OneFinityCNC/onefinity-pcb/BOM/ControllerRev5.xlsx

Controller Revision 5
Bill Of Materials
Item | Quantity | Reference | Part | Manufacturer | Manufacturer Part Number | Description
1 | 10 | C1,C2,C3,C35,C36,C37,C65,C81,C97,C113 | 130p/50V | Kemet | C0805C131J5GAC7800 | CAP CER 130PF 50V NP0 0805
2 | 23 | C4,C5,C6,C7,C8,C9,C18,C19,C24,C25,C28,C32,C33,C34,C62,C78,C94,C110,C115,C119,C120,C121,C123 | 100n/50V | Kemet | C0805C104M5RACTU | CAP CER 0.1UF 50V X7R 0805
3 | 2 | C10,C11 | 10p/50V | Kemet | C0805C100J5GACTU | CAP CER 10PF 50V C0G/NP0 0805
4 | 1 | C12 | 3n3/50V | Kemet | C0805C332K5RACTU | CAP CER 3300PF 50V X7R 0805
5 | 1 | C13 | 22u/16V | Murata | GRM32ER71E226ME15L | CAP CER 22UF 25V X7R 1210
6 | 2 | C14,C124 | 10u/50V | Taiyo Yuden | UMK325BJ106KM-T | CAP CER 10UF 50V X5R 1210
7 | 1 | C15 | 470n/50V | Kemet | C0805C474K5RACTU | CAP CER 0.47UF 50V X7R 0805
8 | 1 | C16 | 100p/16V | Wurth Elektronik | 885012007016 | CAP CER 100PF 16V C0G/NP0 0805
9 | 1 | C17 | 33n/50V | Kemet | C0805C333K5RACTU | CAP CER 0.033UF 50V X7R 0805
10 | 15 | C27,C29,C30,C31,C38,C39,C40,C42,C44,C45,C46,C47,C48,C49,C50 | 220n/16V | Yageo | CC0805KRX7R7BB224 | CAP CER 0.22UF 16V X7R 0805
11 | 13 | U7,C41,C43,C51,C67,R68,R69,R71,R73,C83,C99,R134,R135 | DNI
12 | 8 | C52,C53,C68,C69,C84,C85,C100,C101 | 22u/50V | Wurth | 865080643008 | CAP ALUM 22UF 20% 50V SMD
13 | 8 | C54,C58,C70,C74,C86,C90,C102,C106 | 10n/50V | Yageo | CC0805KRX7R9BB103 | CAP CER 10000PF 50V X7R 0805
14 | 5 | C55,C71,C87,C103,C130 | 150u/50V | Wurth | 865080657017 | CAP ALUM 150UF 20% 50V SMD
15 | 8 | C56,C57,C72,C73,C88,C89,C104,C105 | 22u/63V | Wurth Electronik | 860010773010 | CAP 22 UF 20% 63 V
16 | 4 | C59,C75,C91,C107 | 220n/100V | Taiyo Yuden | HMK212B7224KG-T | CAP CER 0.22UF 100V X7R 0805
17 | 9 | C60,C63,C76,C79,C92,C95,C108,C111,C122 | 1u/50V | Samsung Electro-Mechanics | CL21B105KBFNNNE | CAP CER 1UF 50V X7R 0805
18 | 12 | C61,C64,C66,C77,C80,C82,C93,C96,C98,C109,C112,C114 | 1n/16V | Kemet | C0805C102K4RACTU | CAP CER 1000PF 16V X7R 0805
19 | 1 | C116 | 180u/50V | United Chemi-Con | EKZN500ELL181MH20D | CAP ALUM 180UF 20% 50V RADIAL
20 | 4 | D1,D4,D5,D6 | 3A/40V | STMicroelectronics | STPS3L40UF | DIODE SCHOTTKY 40V 3A SMBFLAT
21 | 2 | D7,D8 | 33V/3kW | Littelfuse | SMDJ33A | ESD Suppressors / TVS Diodes 3kW 33V 5% Uni-Directional
22 | 1 | D9 | LED Green | Lite-On | LTST-S270KGKT | LED GREEN CLEAR CHIP SMD R/A
23 | 1 | D10 | BAV99 | ON Semi | BAV99LT1G | DIODE ARRAY 100V 215MA SOT23-3
24 | 1 | D12 | BAS16 | Nexperia | BAS16,215 | DIODE GP 100V 215MA TO236AB
25 | 1 | J1 | CONN RCPT 20x2 | Amphenol FCI | 68602-440HLF | CONN HEADER VERT 40POS 2.54MM
26 | 1 | J2 | I2C Debug
27 | 1 | J3 | Serial Debug
28 | 2 | J4,J9 | CON6A | FCI | 67996-206HLF | CONN HEADER 6POS .100 STR 15AU
29 | 1 | J5 | Power In | Molex | 39300060
30 | 2 | J7,J8 | LOAD | Amphenol FCI | 10127720-061LF | CONN HEADER R/A 6POS 3MM
31 | 2 | J10,J11 | CON2 | Amphenol FCI | 10127720-021LF | Power to the Board Hdr,Dbl Rw, R/A, T/H 2P, Tin Plating
32 | 4 | J12,J13,J14,J15 | MOTOR | Amphenol ICC (FCI) | 10127720-041LF | CONN HEADER R/A 4POS 3MM
33 | 1 | J16 | Fan | Molex | MOLEX-22-23-2021 | CONN HEADER VERT 2POS 2.54MM
34 | 1 | J17 | Power Button | Molex | 22-23-2041 | CONN HEADER VERT 4POS 2.54MM
35 | 1 | J18 | Rocker Switch | Molex | MOLEX-22-23-2021 | CONN HEADER VERT 2POS 2.54MM
36 | 1 | L1 | 10u | Bourns Inc. | SRN8040-100M | FIXED IND 10UH 3.1A 50 MOHM SMD
37 | 1 | L2 | SRF2012A-121YA | Bourns | SRF2012A-121YA | CMC 400MA 2LN 120OHM SMD AECQ200
38 | 1 | L3 | 470R/700mA | Murata | BLM21AG471SN1D | - Ferrite Bead 0805 (2012 Metric) 700mA 190mOhm
39 | 1 | M1 | RasPi 3B+ | Raspberry Pi | RASPBERRY PI 3 MODEL B+ | RASPBERRY PI 3 MOD B+ BCM2837B0
40 | 4 | M2,M3,M4,M5 | 25MM Standoff M3 | Keystone Electronics | 25515 | HEX STANDOFF M3 NYLON 25MM
41 | 8 | M6,M7,M8,M9,M10,M11,M12,M13 | M3 Screw 5mm | B&F Fastener Supply | MPMS 003 0005 PH | MACH SCREW PAN HEAD PHILLIPS M3
42 | 2 | M14,M17 | IDC Socket 40P | Assmann WSW Components | AWP 40-7540-T | CONN SOCKET 40POS IDC TIN
43 | 2 | M15,M18 | Strain Relief | Assmann WSW Components | AWZ-40-T | CONN STRAIN RELIEF 40POS
44 | 1 | M16 | Ribbon Cable | 3M | 3365/40 300 | CBL RIBN 40COND 0.050 GRAY 100'
45 | 1 | P1 | CONNECTOR DB25 | NorComp | 182-025-113R161 | CONN D-SUB PLUG 25POS R/A SOLDER
46 | 1 | Q1 | 60V/50A | Vishay Siliconix | SUD50P06-15L-E3 | MOSFET P-CH 60V 50A TO252
47 | 6 | Q7,Q11,Q12,Q14,Q15,Q16 | 2N7002 | Vishay Siliconix | 2N7002K-T1-E3 | MOSFET N-CH 60V 300MA SOT-23
48 | 1 | Q10 | MMBT2907 | Diodes Inc | MMBT2907A-7-F | TRANS PNP 60V 0.6A SOT23-3
49 | 1 | Q13 | DMG2305 | Diodes Incorporated | DMG2305UX-13 | MOSFET P-CH 20V 4.2A SOT23
50 | 7 | R1,R5,R64,R88,R99,R110,R121 | 2k4 | Yageo | RC0805FR-072K4L | RES SMD 2.4K OHM 1% 1/8W 0805
51 | 25 | R2,R3,R4,R6,R7,R55,R56,R61,R79,R81,R84,R89,R90,R92,R95,R100,R101,R103,R106,R111,R112,R114,R117,R122,R127 | 180R | Stackpole Electronics Inc | RMCF0805JT180R | RES 180 OHM 5% 1/8W 0805
52 | 1 | R8 | 10k5 | Yageo | RC0805FR-0710K5L | RES 10.5K OHM 1% 1/8W 0805
53 | 1 | R9 | 180k | Yageo | RC0805FR-07180KL | RES SMD 180K OHM 1% 1/8W 0805
54 | 11 | R10,R43,R506,R509,R511,R512,R520,R524,R530,R532,R536 | 10k | Yageo | RC0805FR-0710KL | RES SMD 10K OHM 1% 1/8W 0805
55 | 1 | R11 | 330R | Yageo | RC0805FR-07330RL | RES SMD 330 OHM 1% 1/8W 0805
56 | 2 | R12,R13 | 1k37 | Yageo | RC0805FR-071K37L | RES SMD 1.37K OHM 1% 1/8W 0805
57 | 1 | R14 | 1k5 | Yageo | RC0805FR-071K5L | RES SMD 1.5K OHM 1% 1/8W 0805
58 | 7 | R32,R33,R129,R130,R507,R508,R531 | 37k4 | Yageo | RC0805FR-0737K4L | RES SMD 37.4K OHM 1% 1/8W 0805
59 | 6 | R36,R37,R47,R48,R131,R521 | 1k | Yageo | RC0805FR-071KL | RES SMD 1K OHM 1% 1/8W 0805
60 | 3 | R49,R50,R519 | 0R | Yageo | RC0805JR-070RL | RC0805JR-070RL
61 | 15 | R51,R52,R54,R58,R62,R65,R66,R67,R70,R72,R74,R75,R76,R77,R78 | 68R | Stackpole Electronics Inc | RMCF0805FT68R0 | RES 68 OHM 1% 1/8W 0805
62 | 2 | R53,R63 | 750R | Yageo | RC0805FR-07750RL | RES SMD 750 OHM 1% 1/8W 0805
63 | 2 | R57,R60 | 10R | Stackpole Electronics Inc | RMCF0805FT10R0 | RES 10 OHM 1% 1/8W 0805
64 | 1 | R59 | 137R | Yageo | RC0805FR-07137RL | RES SMD 137 OHM 1% 1/8W 0805
65 | 16 | R80,R83,R85,R87,R91,R94,R96,R98,R102,R105,R107,R109,R113,R116,R118,R120 | 75R | Stackpole Electronics Inc | RMCF0805FT75R0 | RES 75 OHM 1% 1/8W 0805
66 | 14 | R82,R86,R93,R97,R104,R108,R115,R119,R501,R504,R513,R516,R526,R527 | 0R05/3W | Bourns Inc. | CRA2512-FZ-R050ELF | RES 0.05 OHM 1% 3W 2512
67 | 4 | R136,R137,R138,R139 | 1k5/1W | Stackpole | RMCF2512FT1K50 | RES 1.5K OHM 1% 1W 2512
68 | 2 | R502,R528 | 150k | Yageo | RC0805FR-07150KL | RES 150K OHM 1% 1/8W 0805
69 | 11 | R503,R505,R510,R515,R518,R523,R525,R529,R533,R534,R535 | 100k | Yageo | RC0805FR-07100KL | RES SMD 100K OHM 1% 1/8W 0805
70 | 2 | R514,R517 | 200k | Yageo | RC0805FR-07200KL | RES 200K OHM 1% 1/8W 0805
71 | 1 | R522 | 300k | Yageo | RC0805FR-07300KL | RES SMD 300K OHM 1% 1/8W 0805
72 | 1 | TP1 | T POINT R
73 | 30 | TP2,TP3,TP4,TP5,TP6,TP7,TP8,TP9,TP10,TP11,TP12,TP13,TP14,TP15,TP16,TP17,TP18,TP19,TP20,TP21,TP22,TP23,TP24,TP25,TP26,TP27,TP28,TP29,TP30,TP31 | TEST_POINT
74 | 1 | U1 | ATXMEGA192A3U-AU | Atmel | ATXMEGA192A3U-AU | IC MCU 16BIT 192KB FLASH 64TQFP
75 | 1 | U2 | L7986A | STMicroelectronics | L7986A | IC REG BUCK ADJUSTABLE 3A 8HSOP
76 | 1 | U3 | AZ1117IH-3.3 | Diodes Incorporated | AZ1117IH-3.3TRG1 | IC REG LINEAR 3.3V 800MA SOT223
77 | 1 | U5 | ATTINY1634R-SU | Atmel | ATTINY1634R-SU | IC MCU 8BIT 16KB FLASH 20SOIC
78 | 1 | U6 | ISL83485 | Renesas | ISL83485IBZ-T | IC TRANSCEIVER HALF 1/1 8SOIC
79 | 16 | U8,U10,U11,U12,U13,U15,U16,U17,U18,U20,U21,U22,U23,U25,U26,U27 | IPG20N06S4L26ATMA1 | Infineon Technologies | IPG20N06S4L26ATMA1 | MOSFET 2N-CH 60V 20A TDSON-8
80 | 4 | U9,U14,U19,U24 | DRV8711 | Texas Instruments | DRV8711DCPR | IC MTR DRV BIPOLR 8-52V 38HTSSOP
81 | 1 | U28 | SN74LV1T34DBVR | Texas Instruments | SN74LV1T34DBVR | IC BUF NON-INVERT 5.5V SOT23-5
82 | 4 | U34,U36,U37,U38 | HV7801 | Microchip | HV7801K1-G | IC CURRENT MONITOR SOT23-5
83 | 1 | U35 | FDS9958 | Diodes Inc | ZXMP6A18DN8TA | Mosfet Array 2 P-Channel (Dual) 60V 3.7A 1.8W Surface Mount 8-SO
84 | 1 | Y1 | 16MHz | Abracon LLC | ABLS-16.000MHZ-B4-T | CRYSTAL 16.0000MHZ 18PF SMD
