OneFinityCNC/onefinity-pcb/Schematics/onefinity-cnc-rev5.pdf

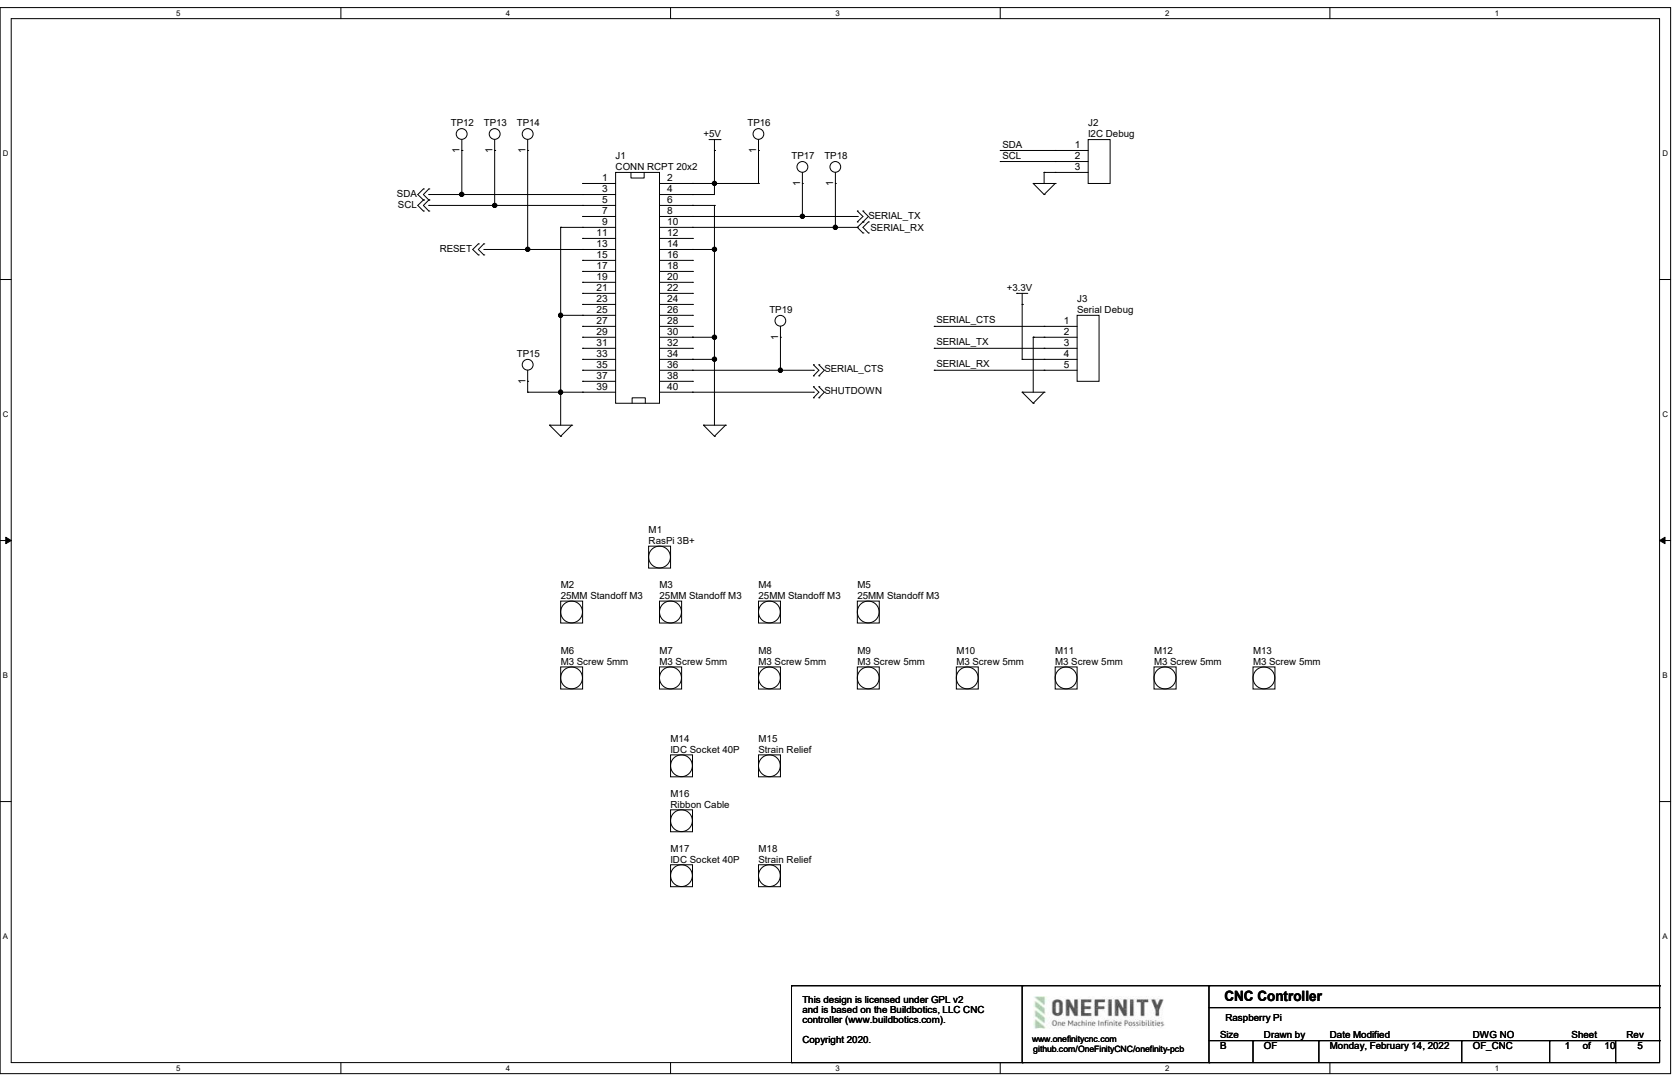
[picture p1: page 1]

This design is licensed under GPL v2
and is based on the Buildbotics, LLC CNC
controller (www.buildbotics.com).

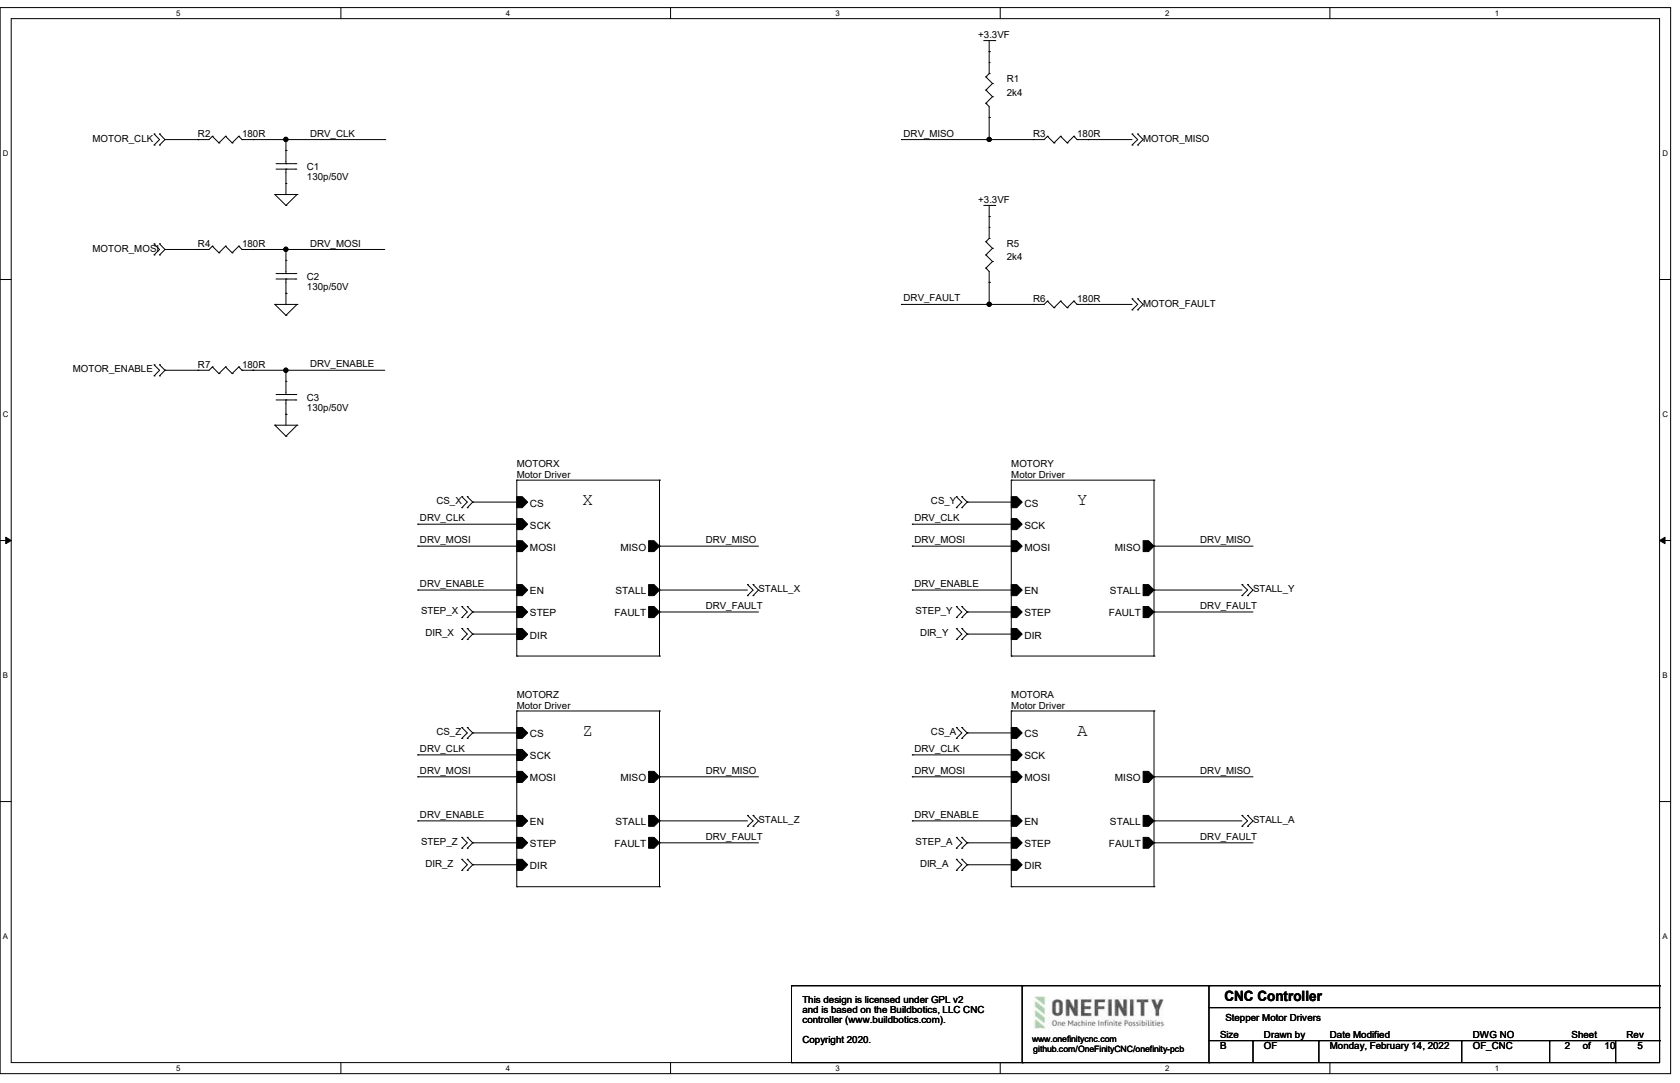
[picture p2: page 2]

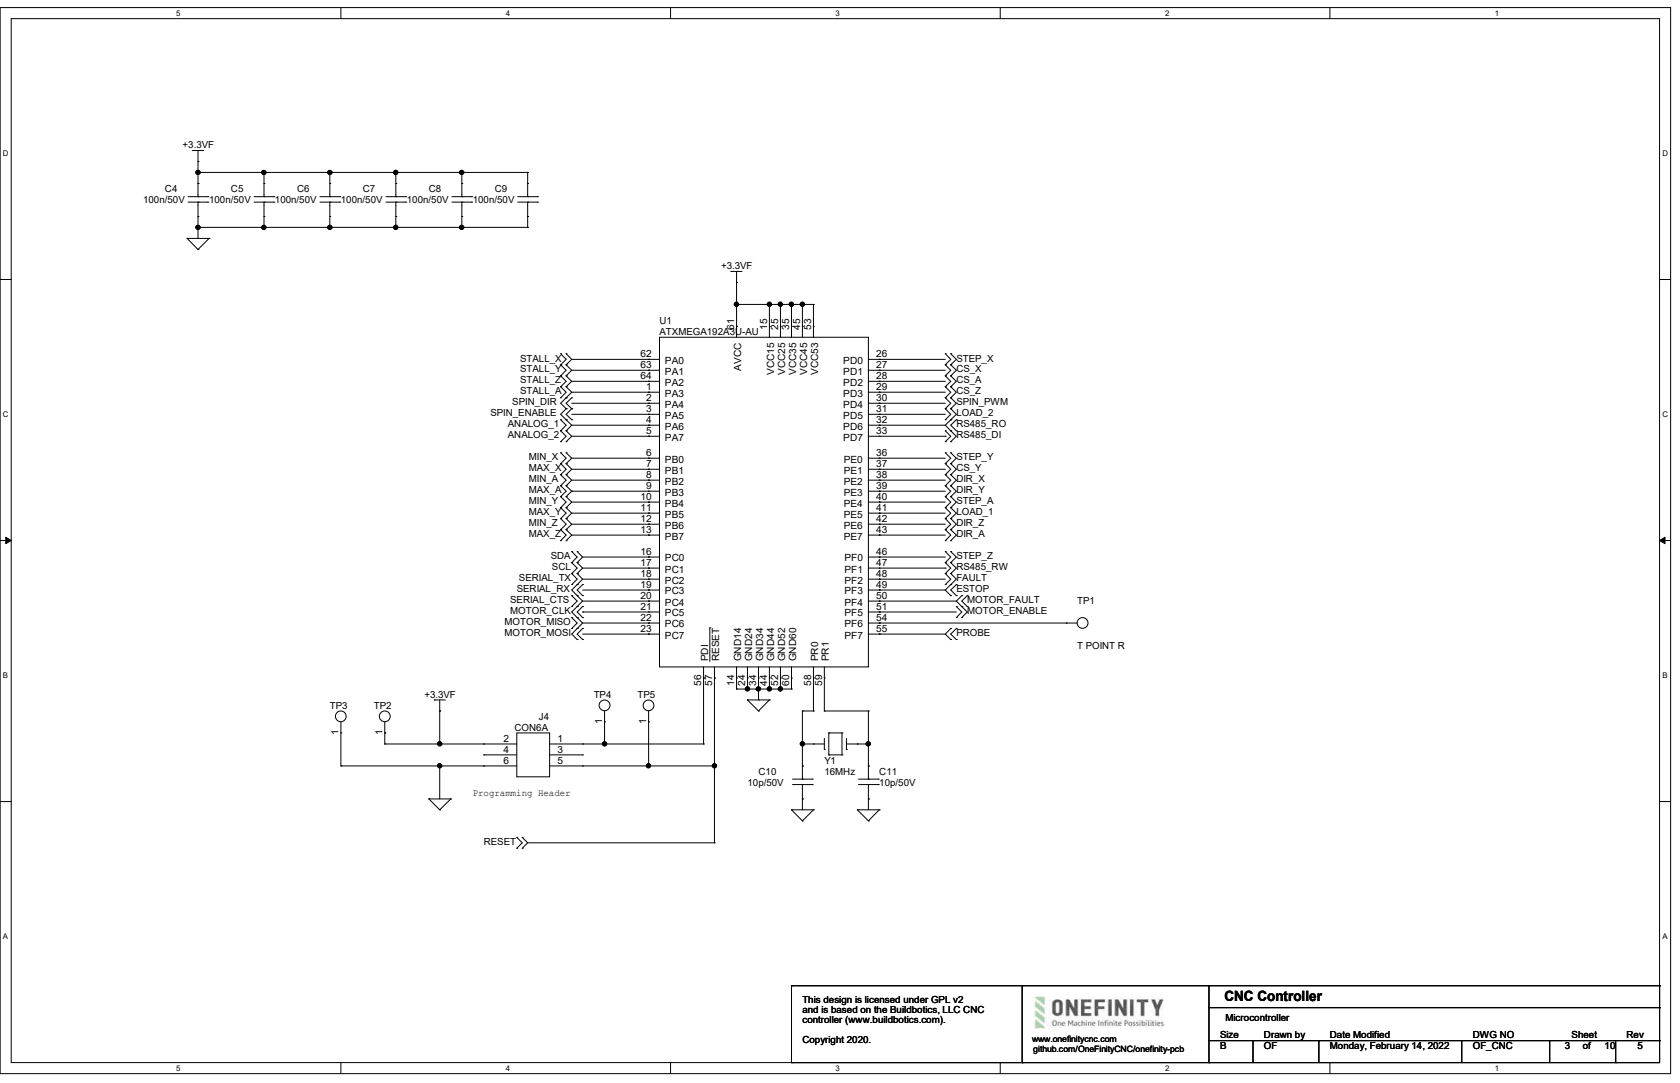
[picture p3: page 3]

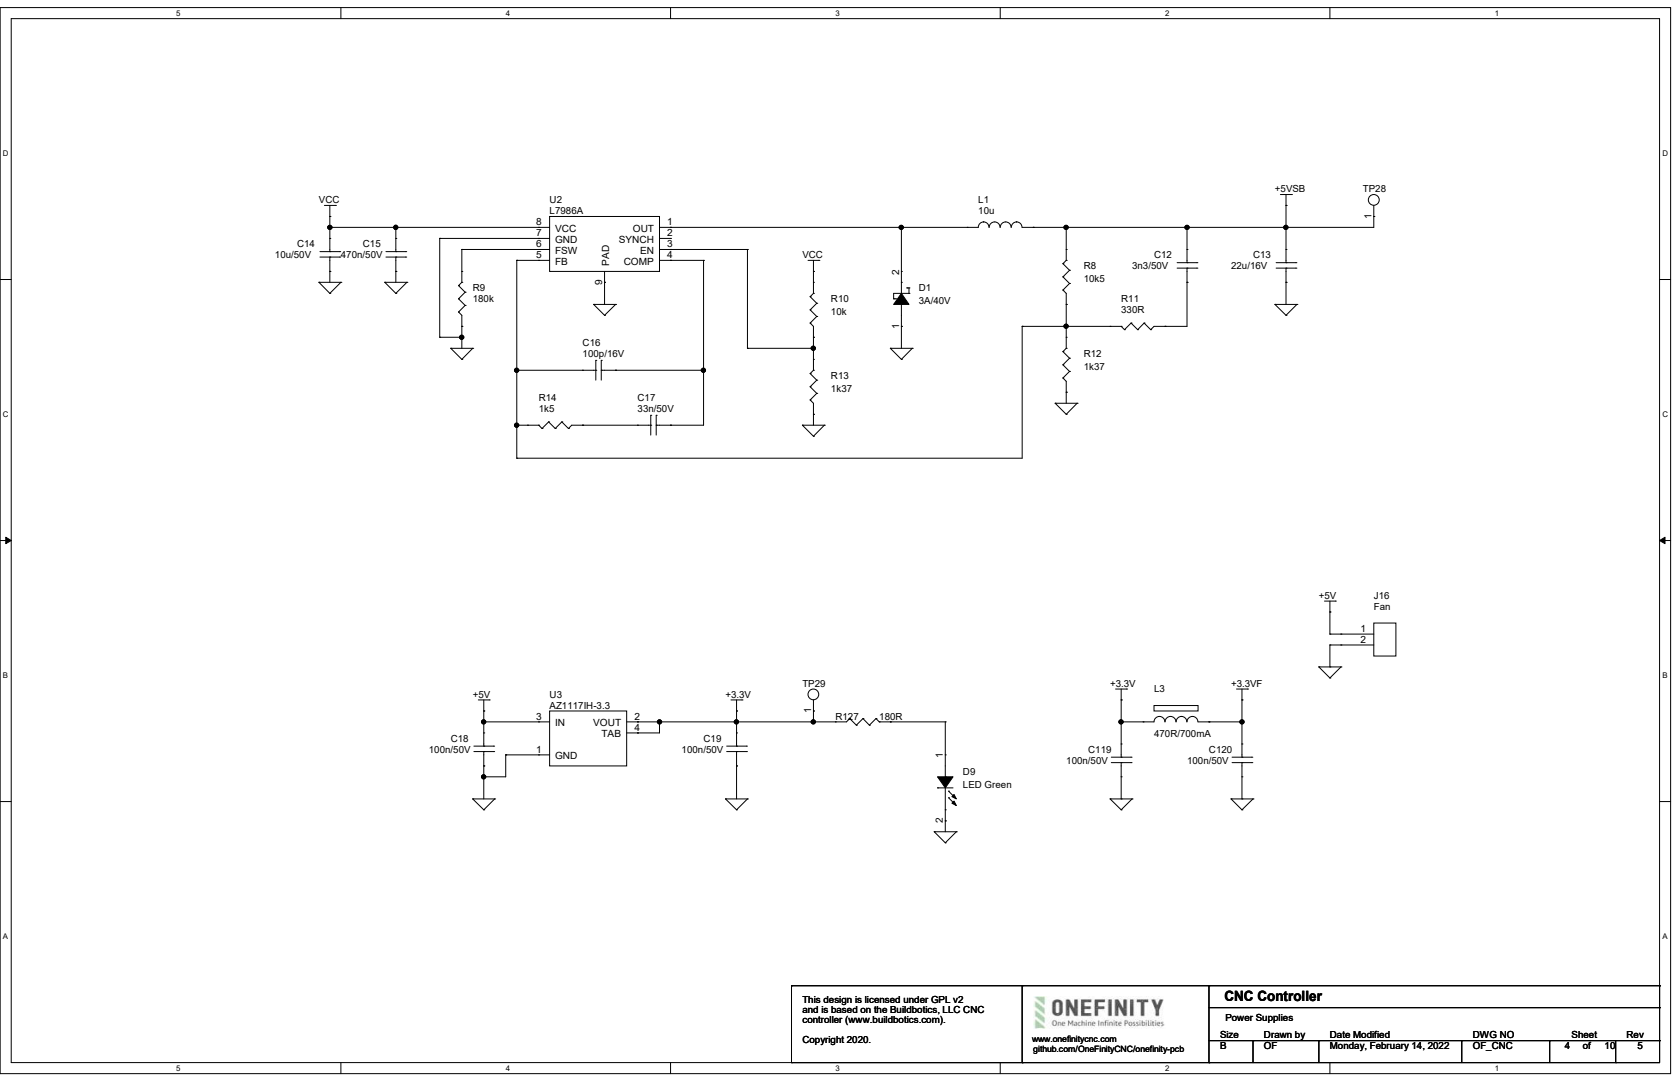
[picture p4: page 4]

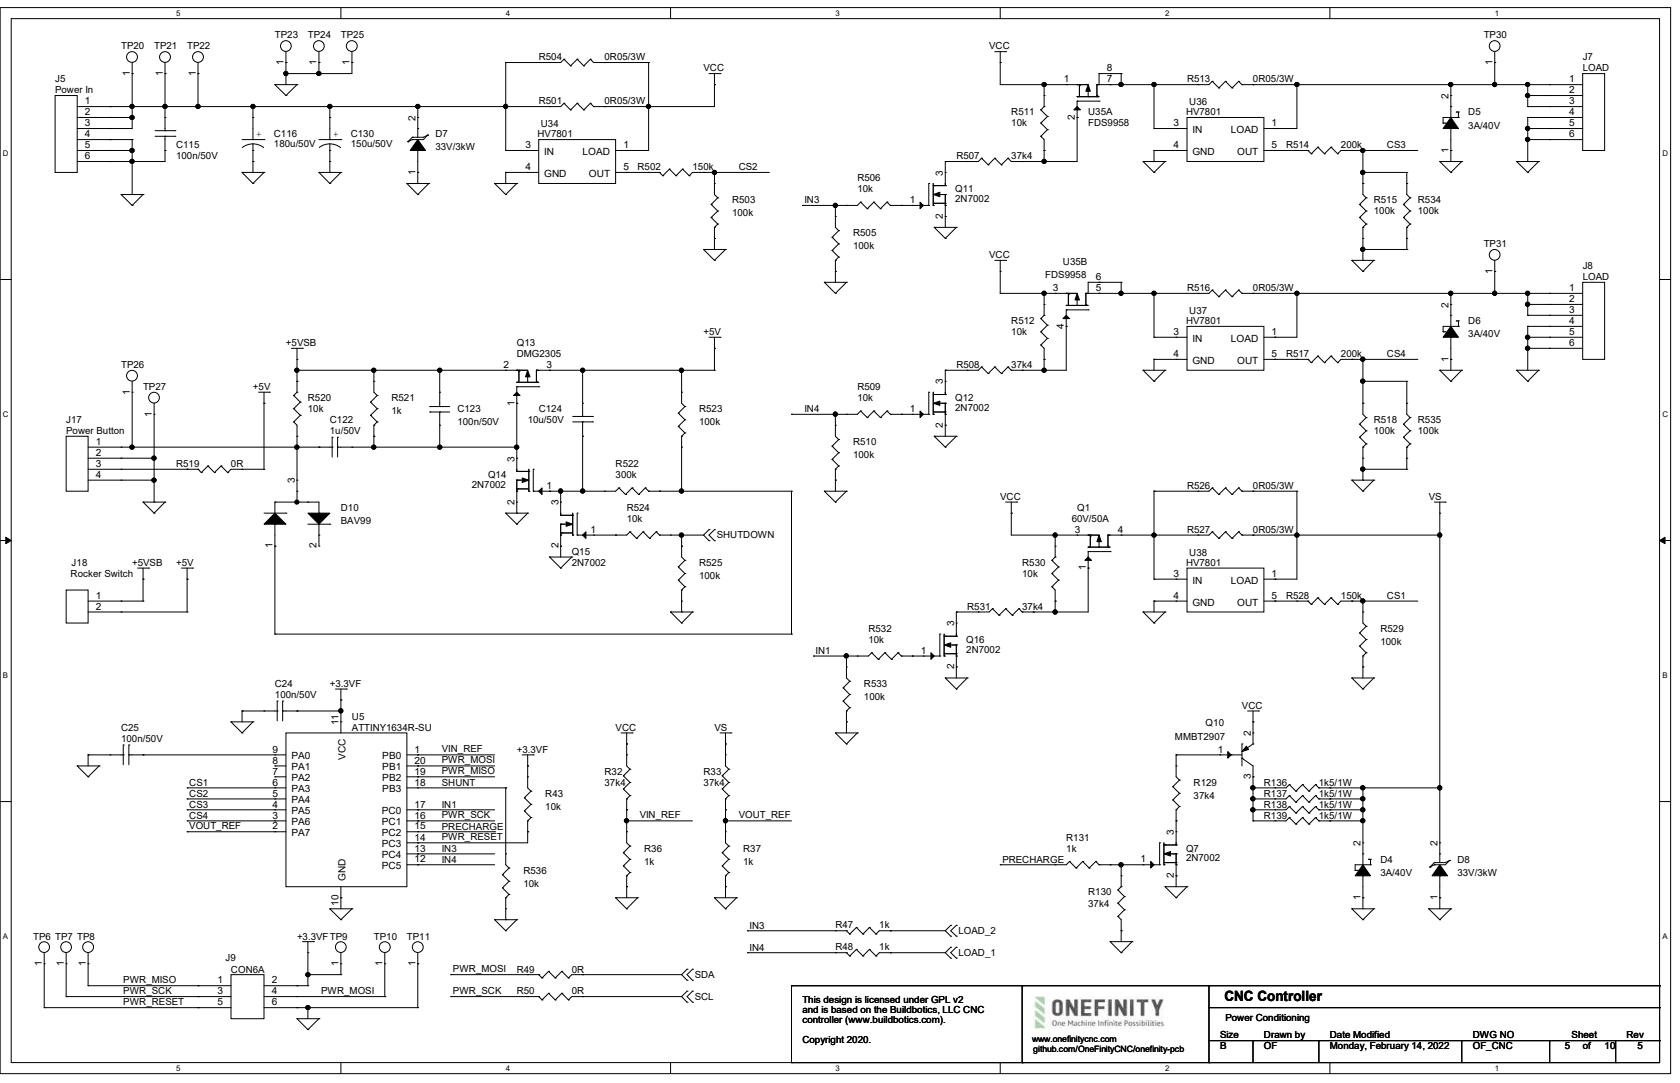
[picture p5: page 5]

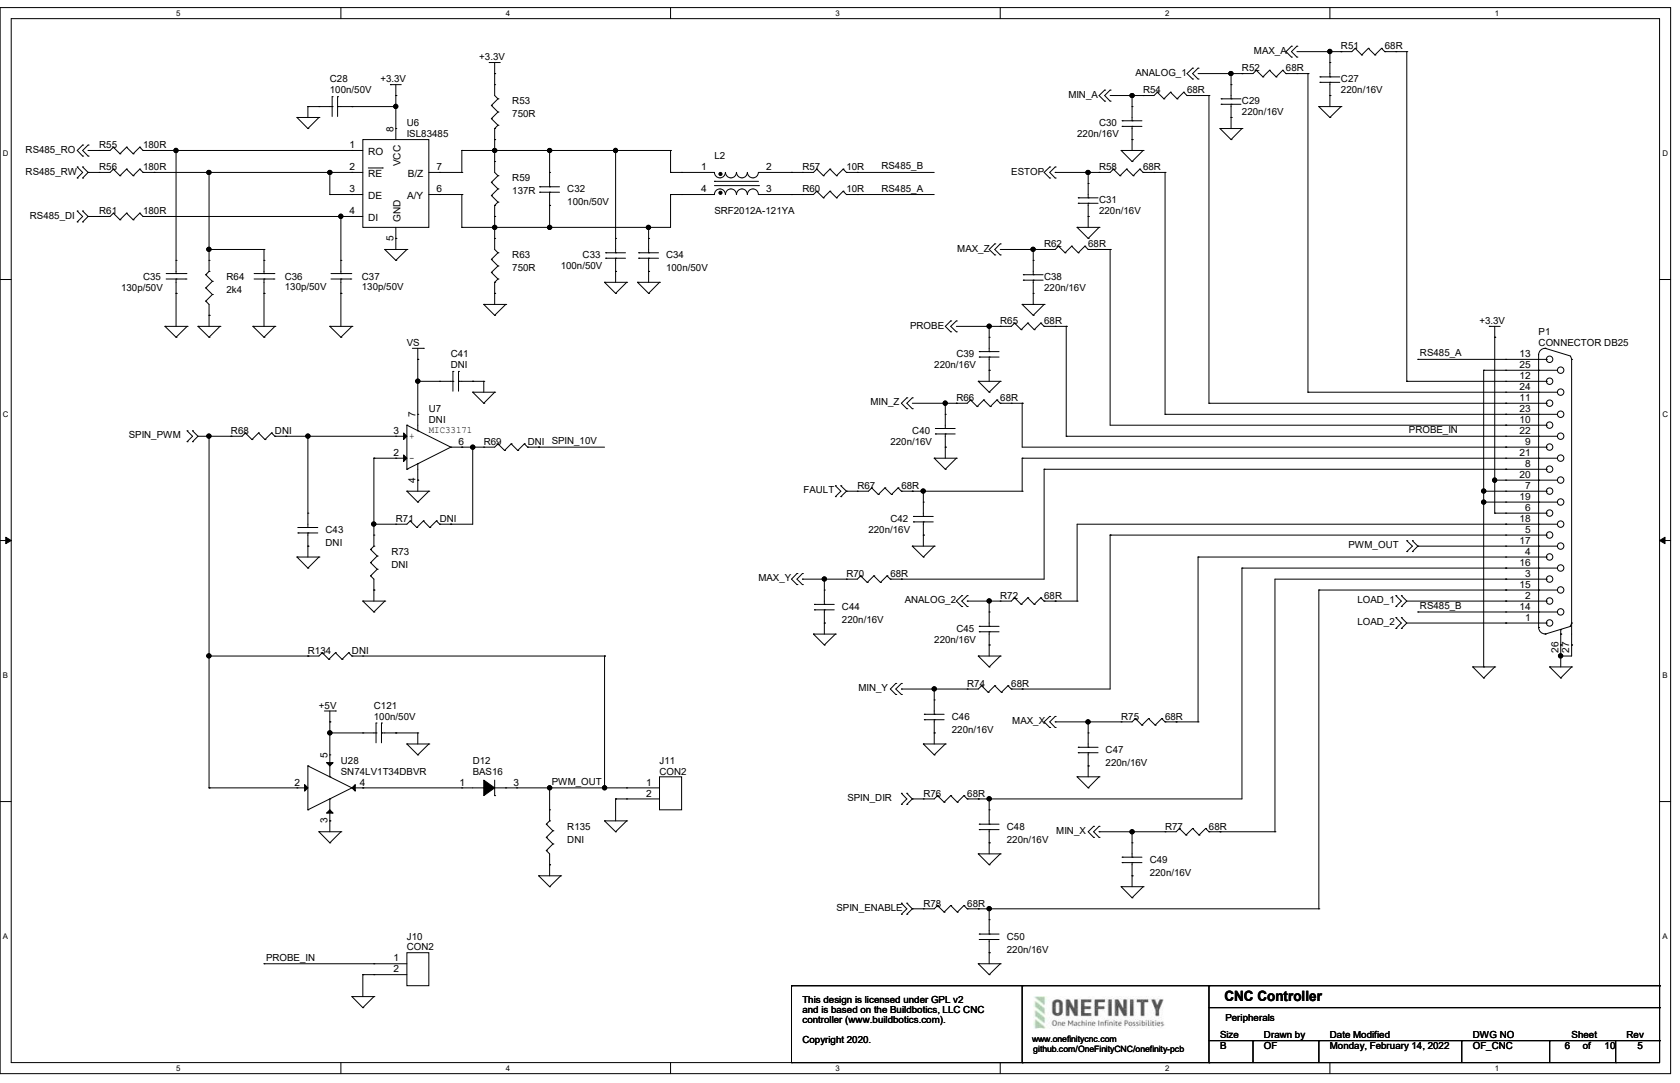
[picture p6: page 6]

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
PWM_OUT | 17 4

16
15

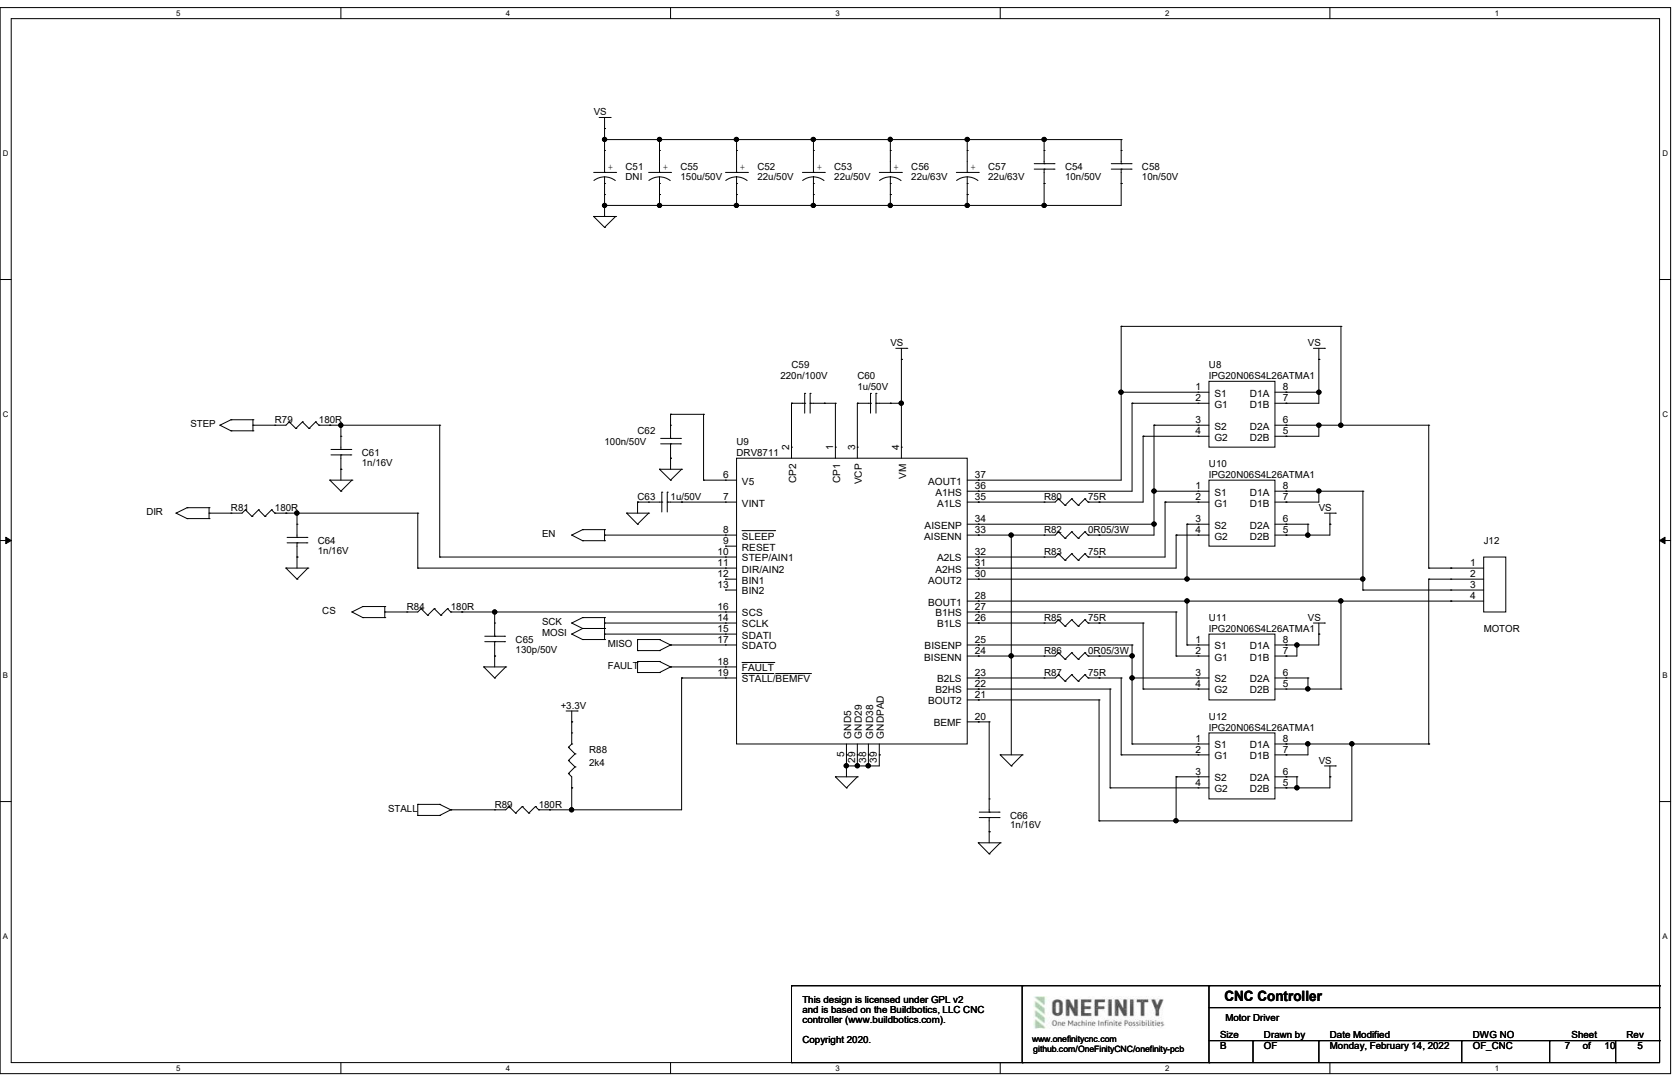
[picture p7: page 7]

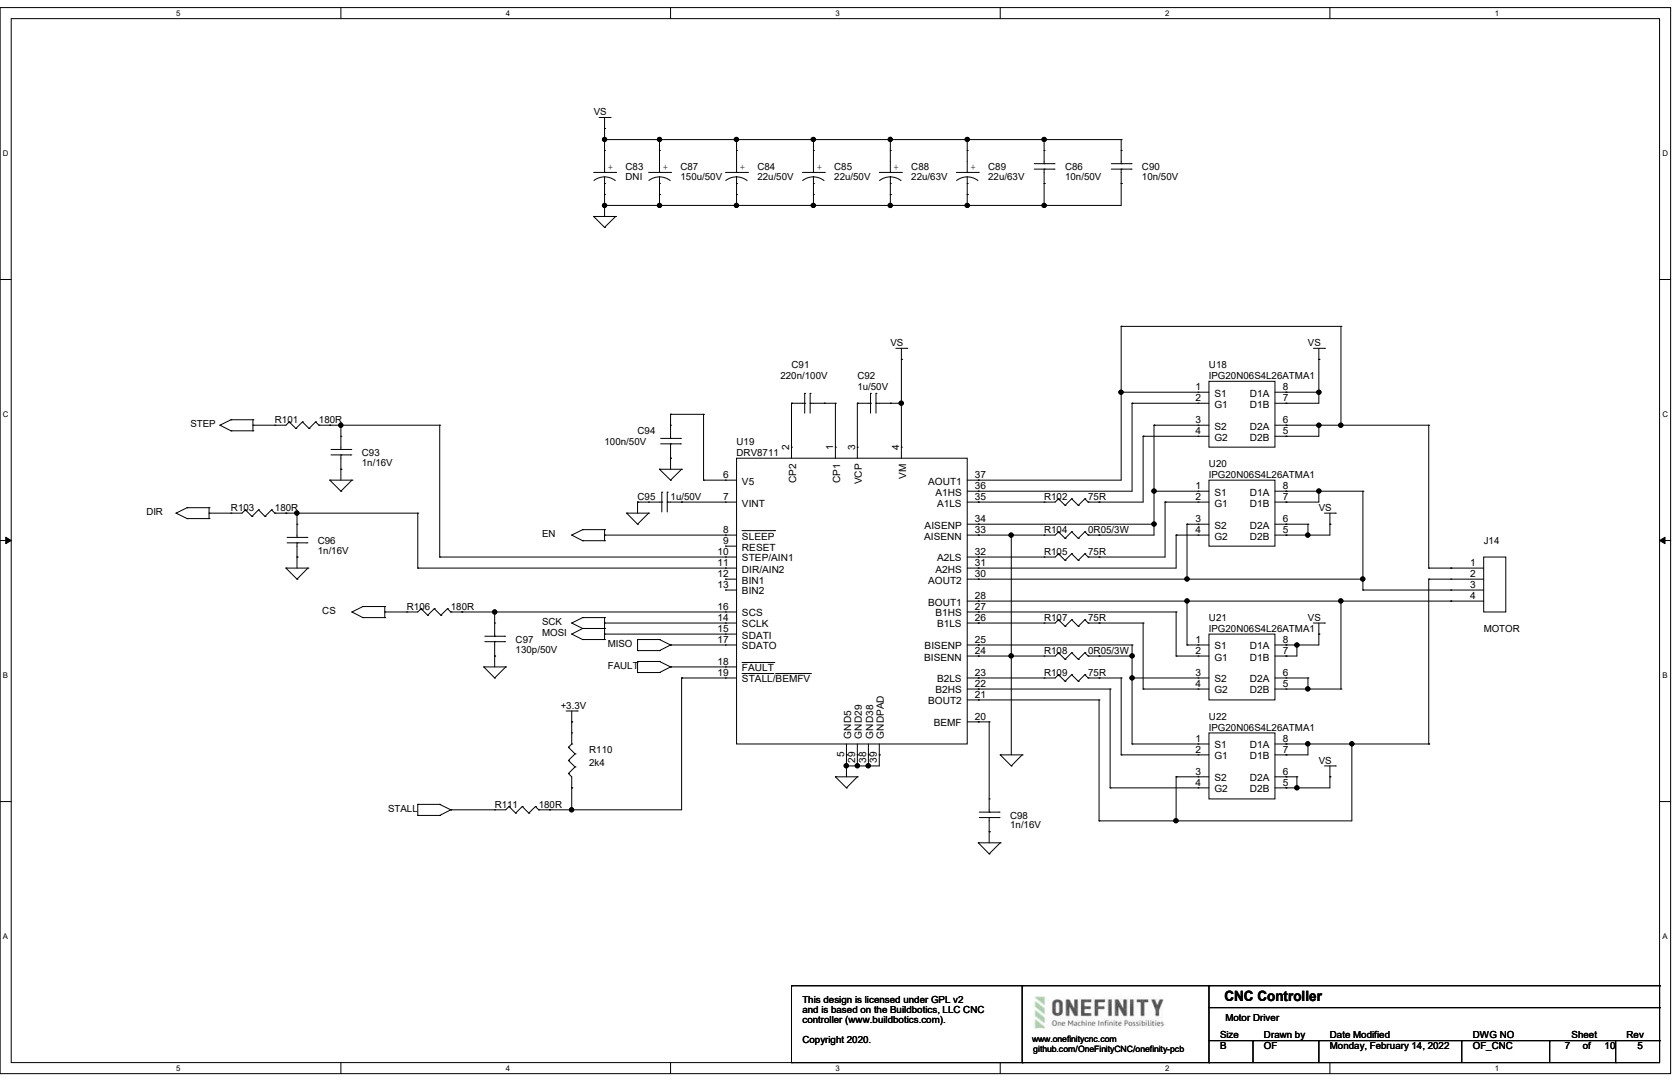
[picture p8: page 8]

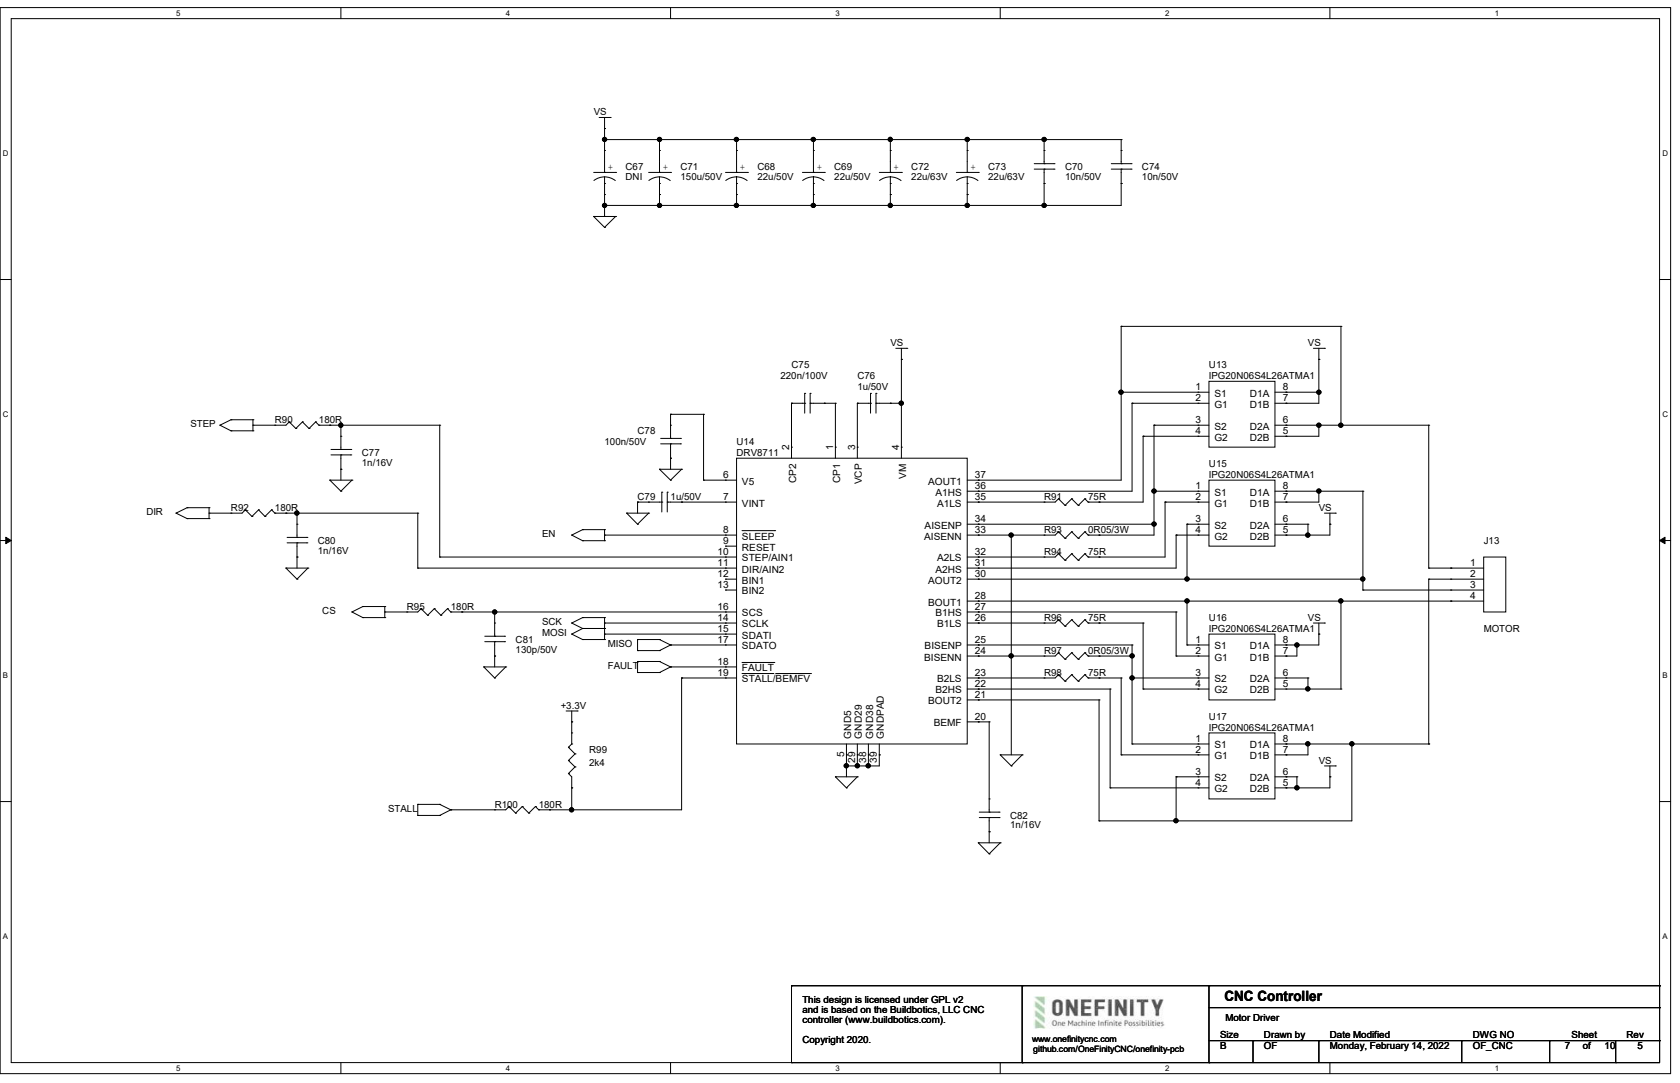
[picture p9: page 9]

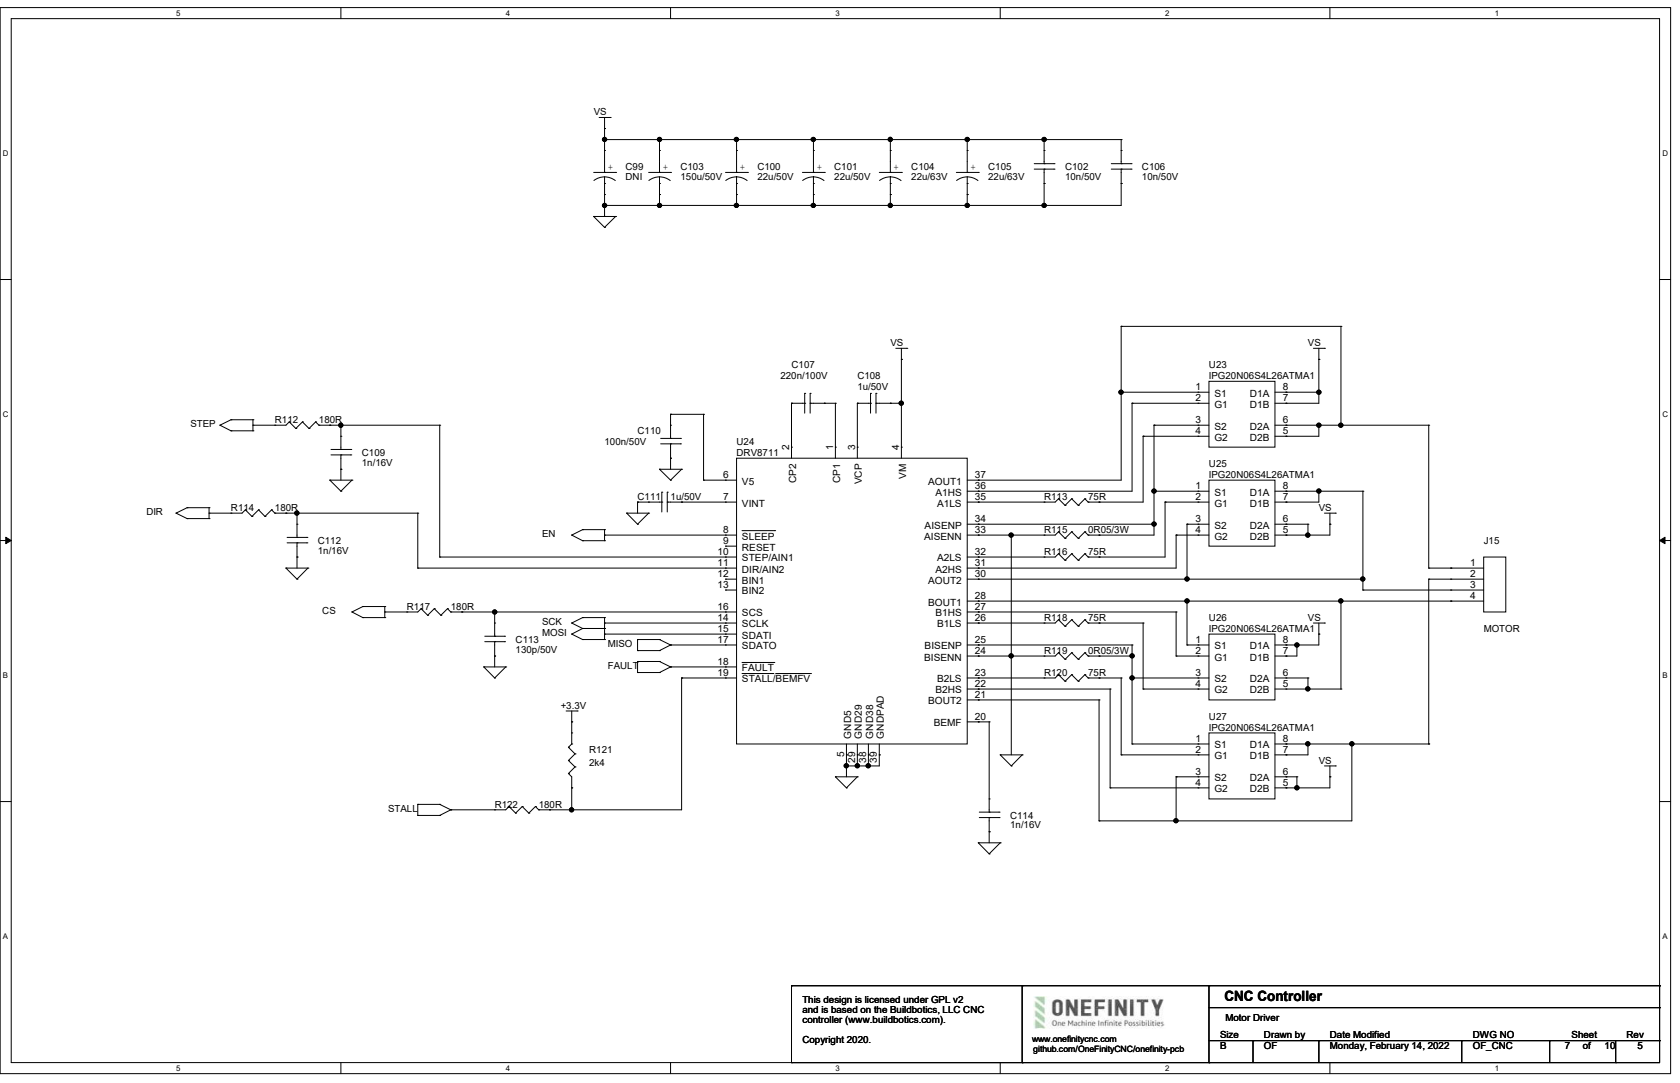
[picture p10: page 10]
