OneFinityCNC/onefinity-pcb/Gerber/controller-gerber-rev5.pdf

## ART FILM - TOP

C130

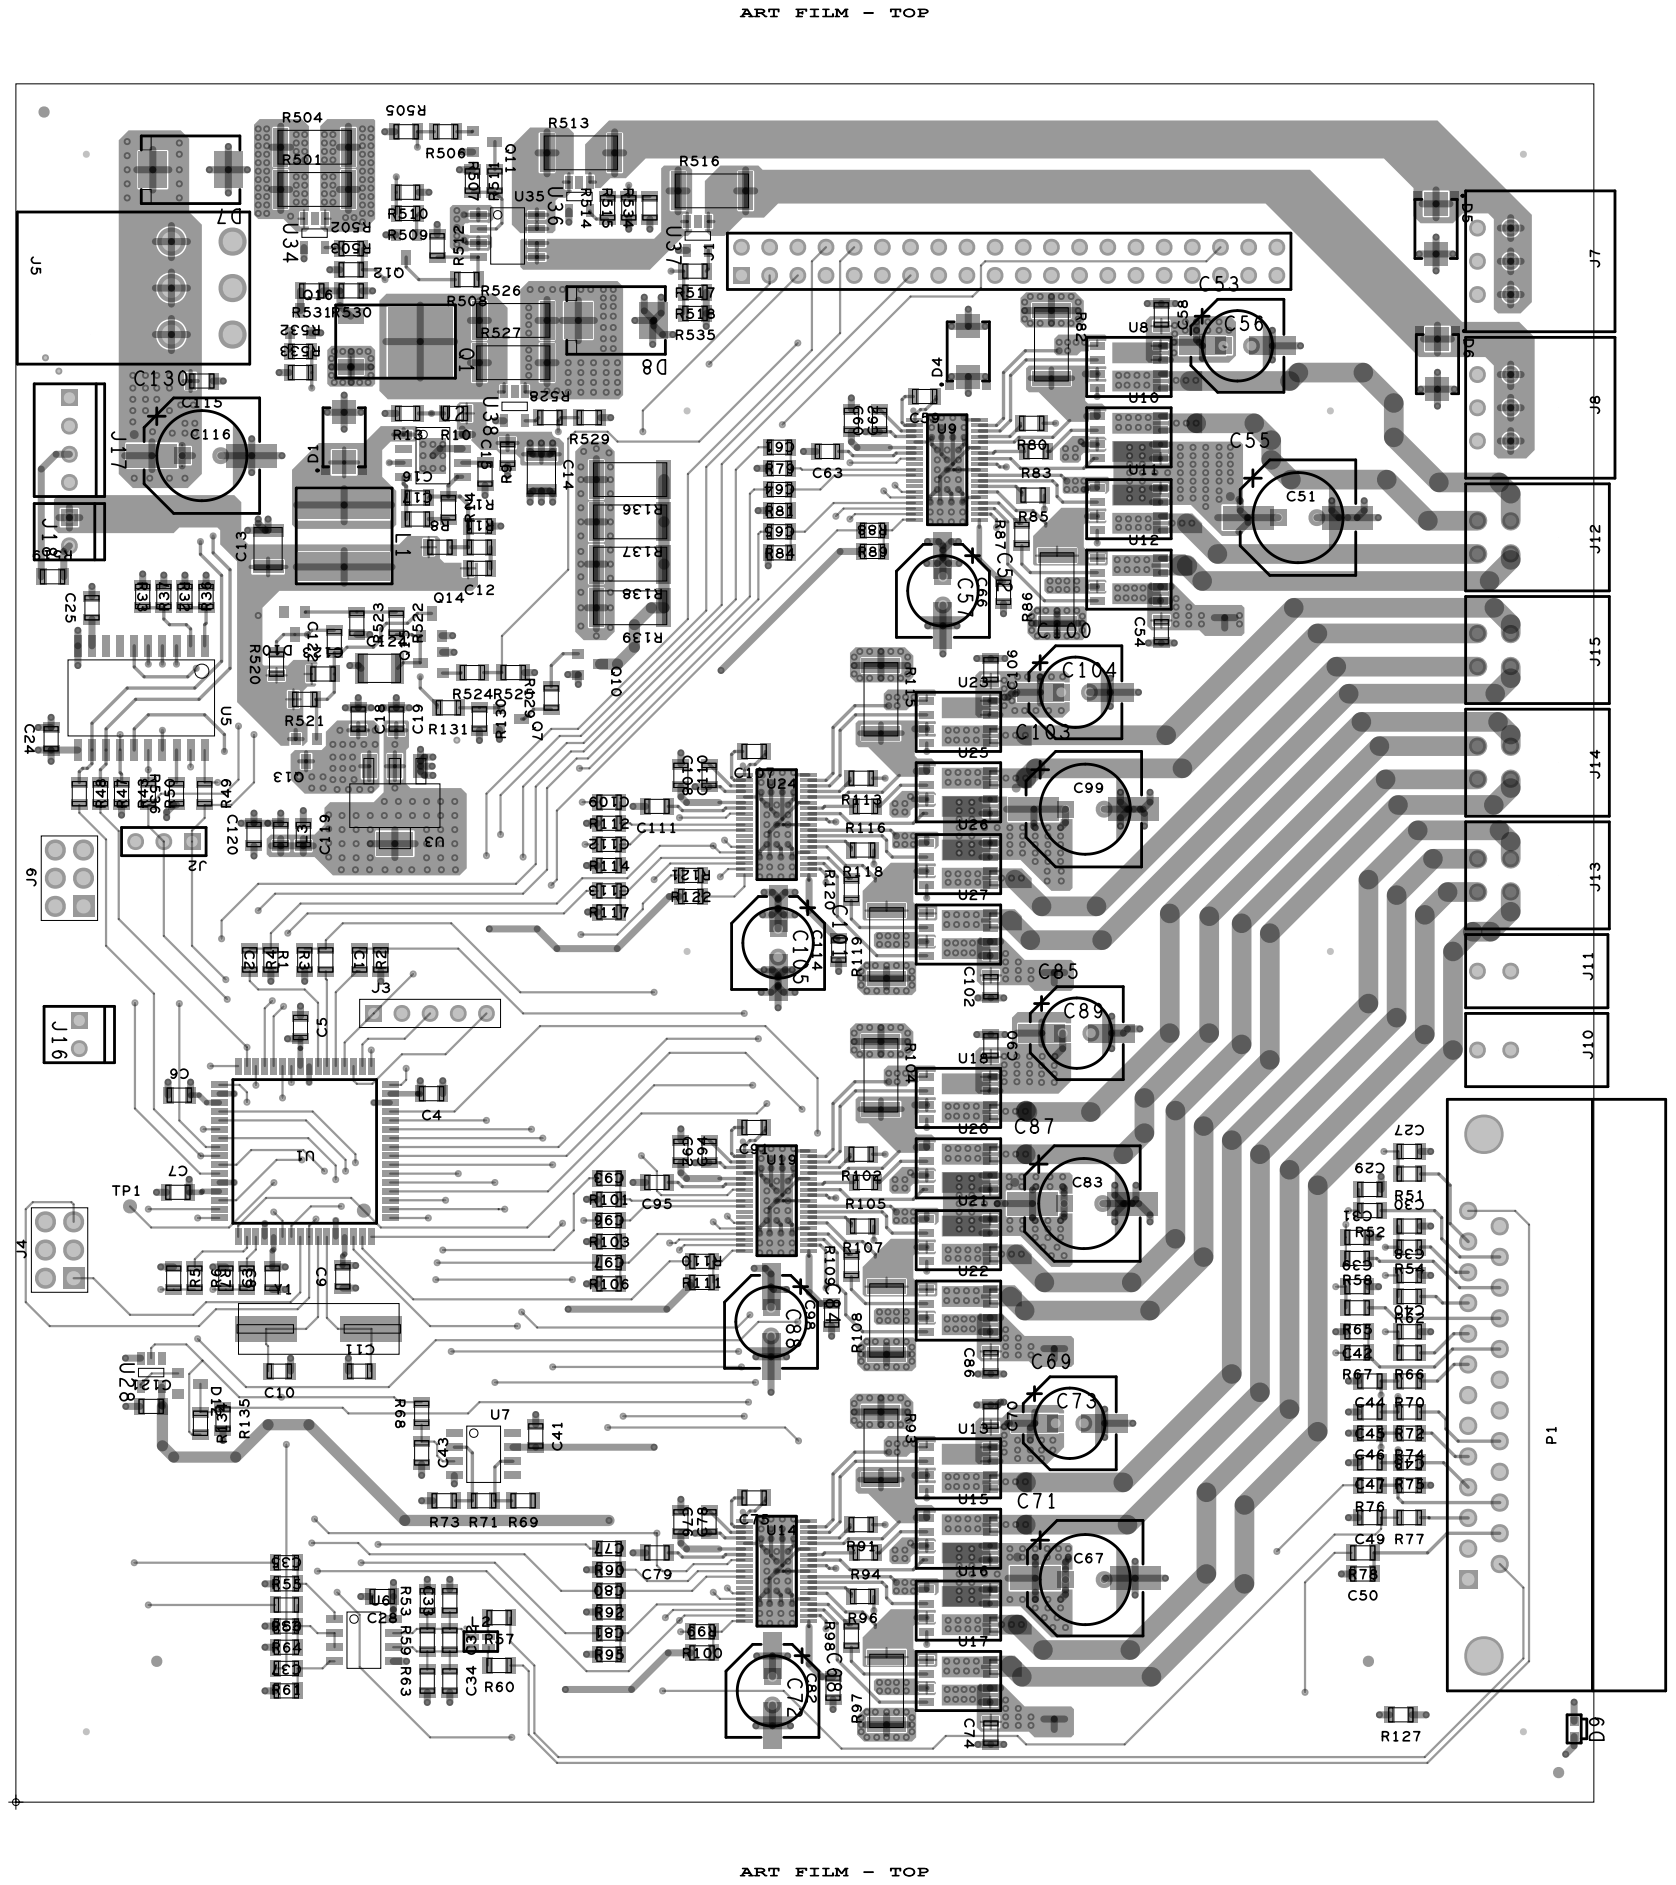
[picture p11: page 1]

## ART FILM - GND

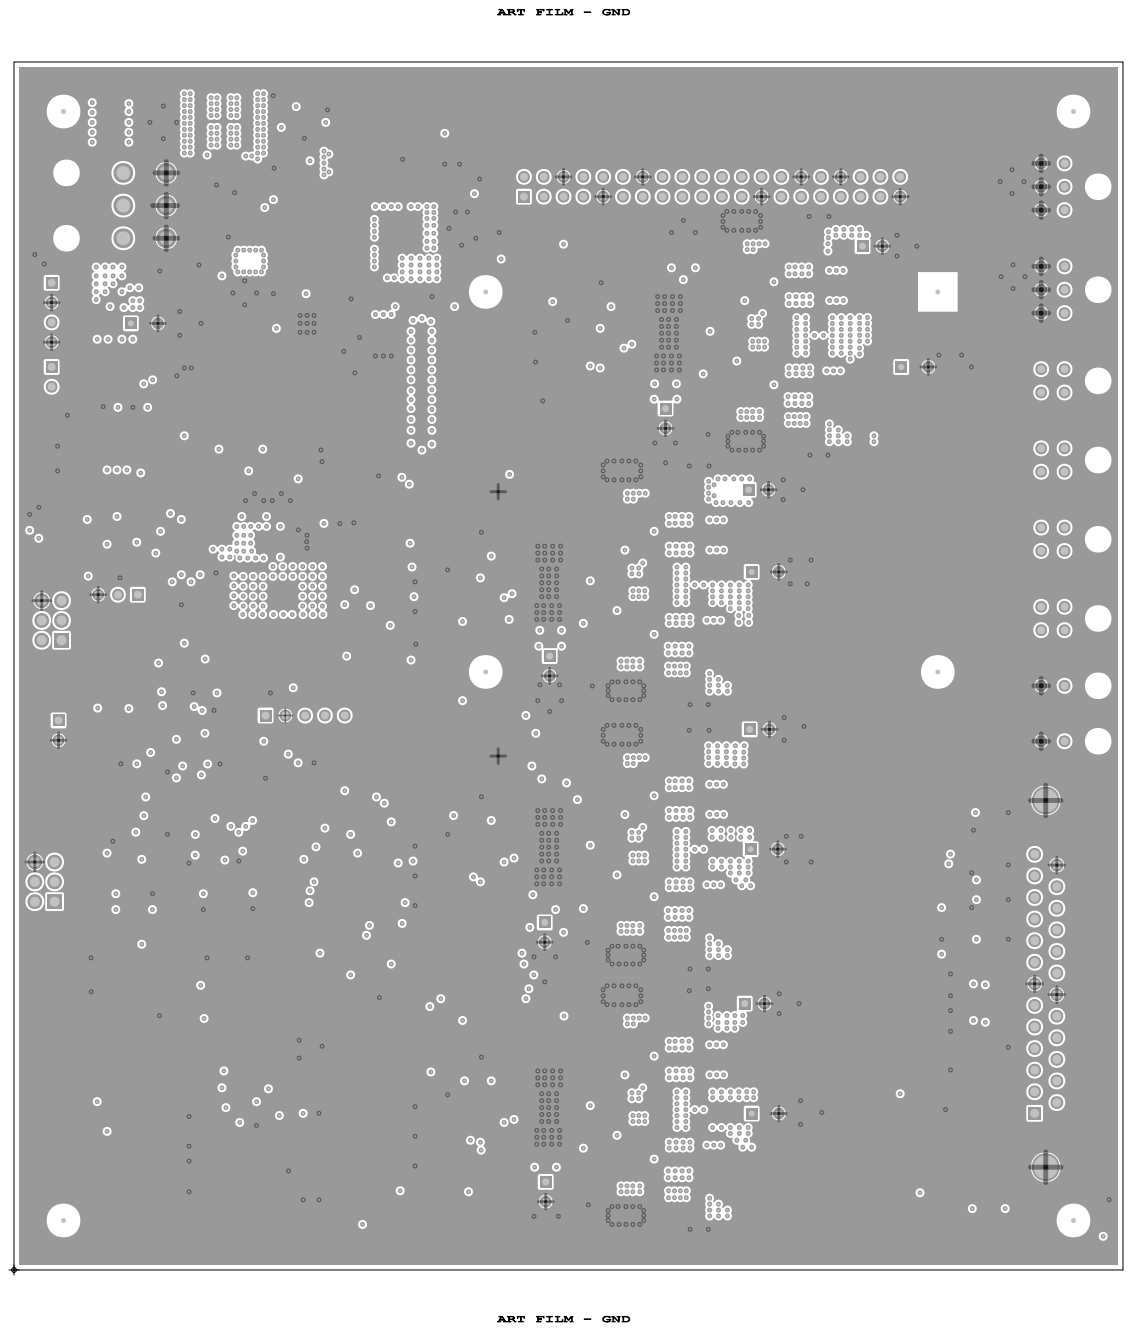
[picture p12: page 2]

ART FILM - GND

## ART FILM - PWR

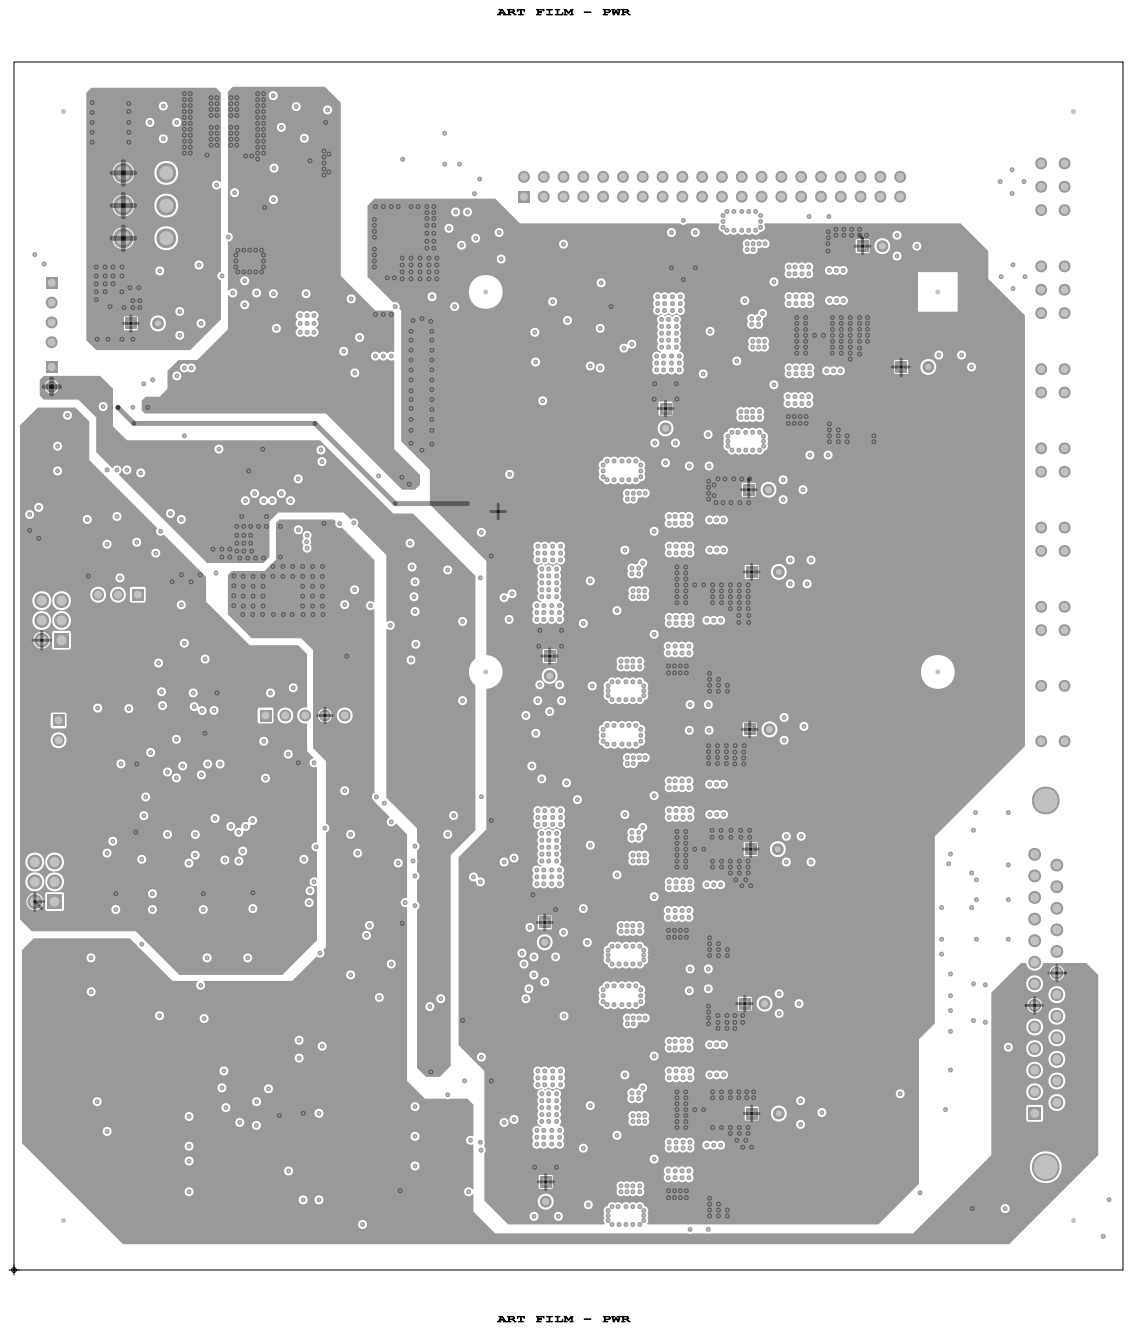
[picture p13: page 3]

ART FILM - PWR

## ART FILM - BOTTOM

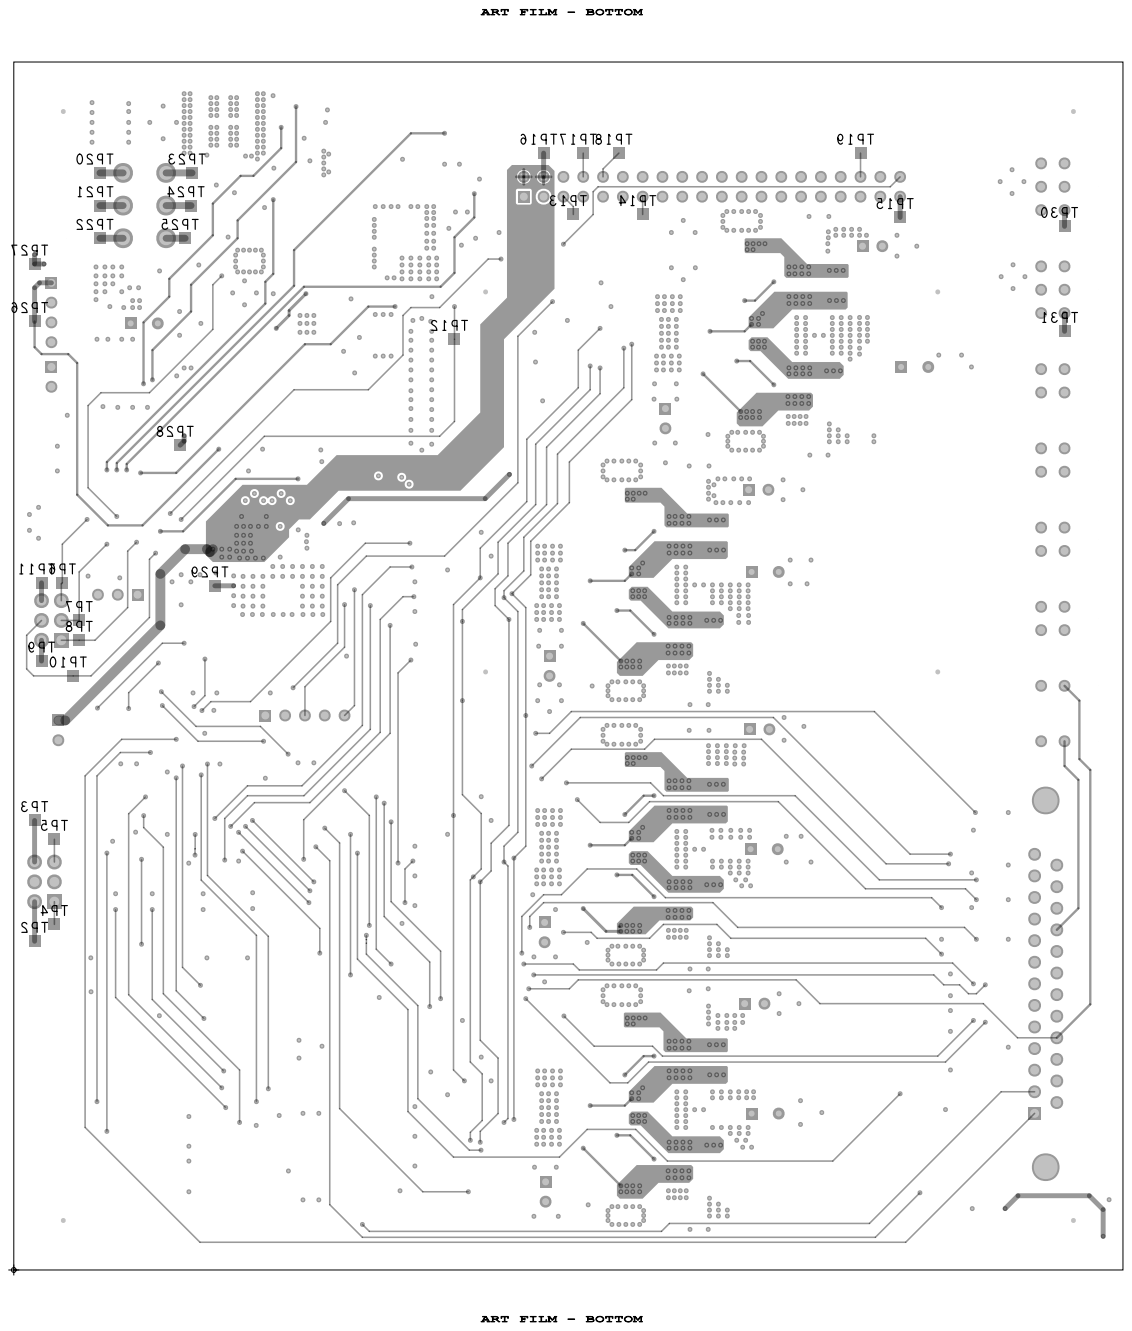
[picture p14: page 4]

## ART FILM - SMT

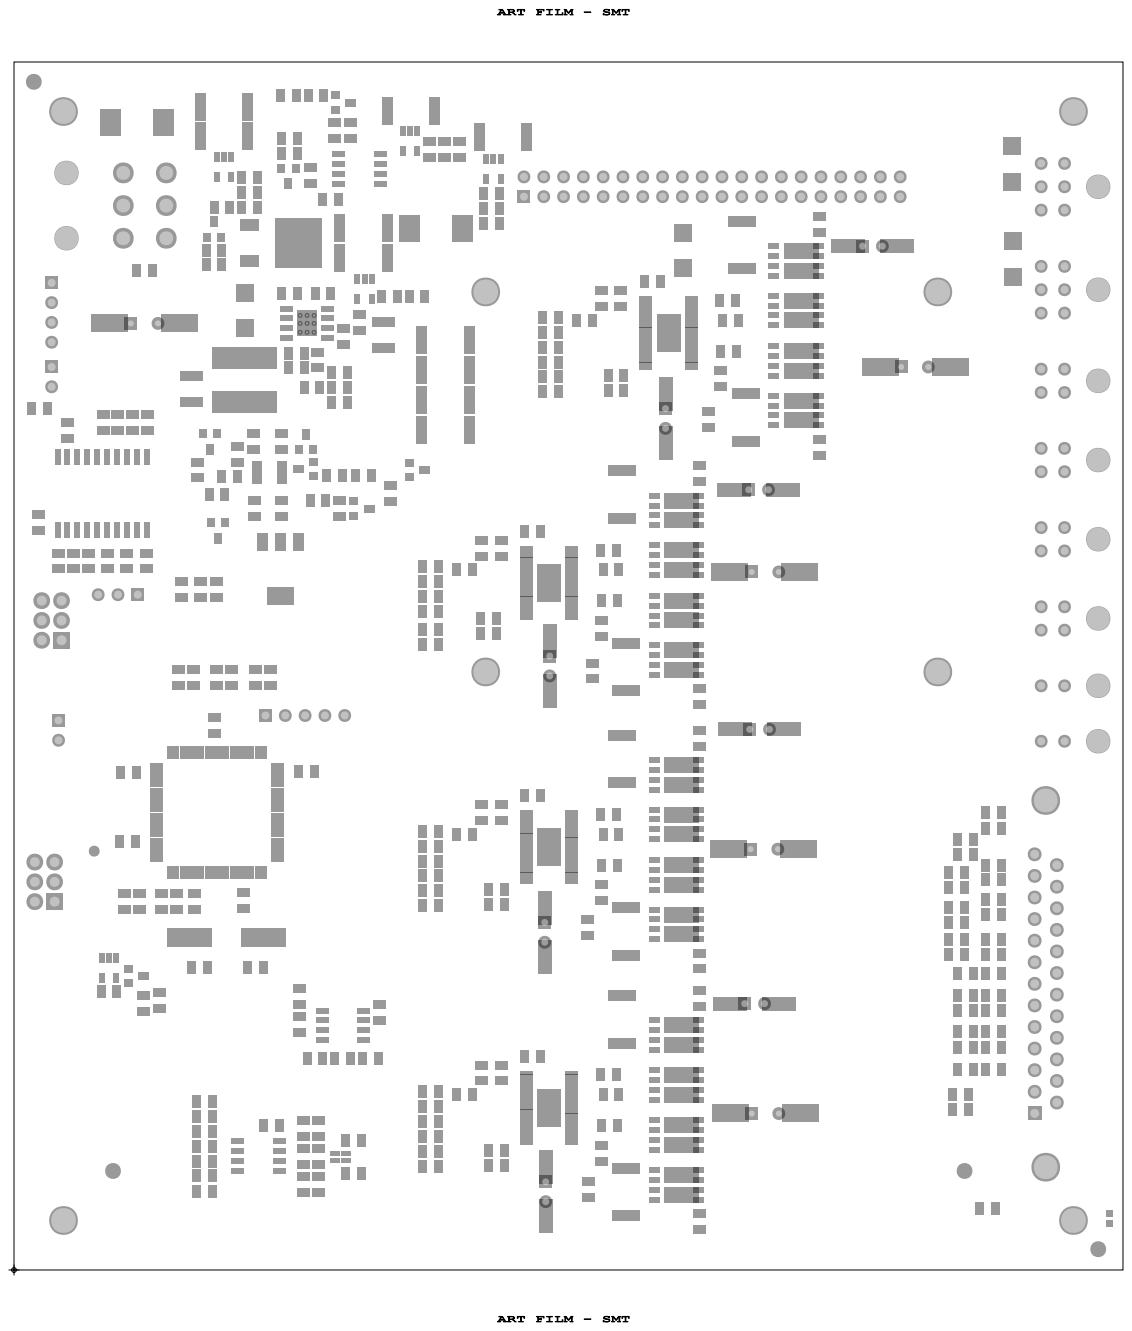
[picture p15: page 5]

ART FILM - SMT

## ART FILM - SST

R530R509

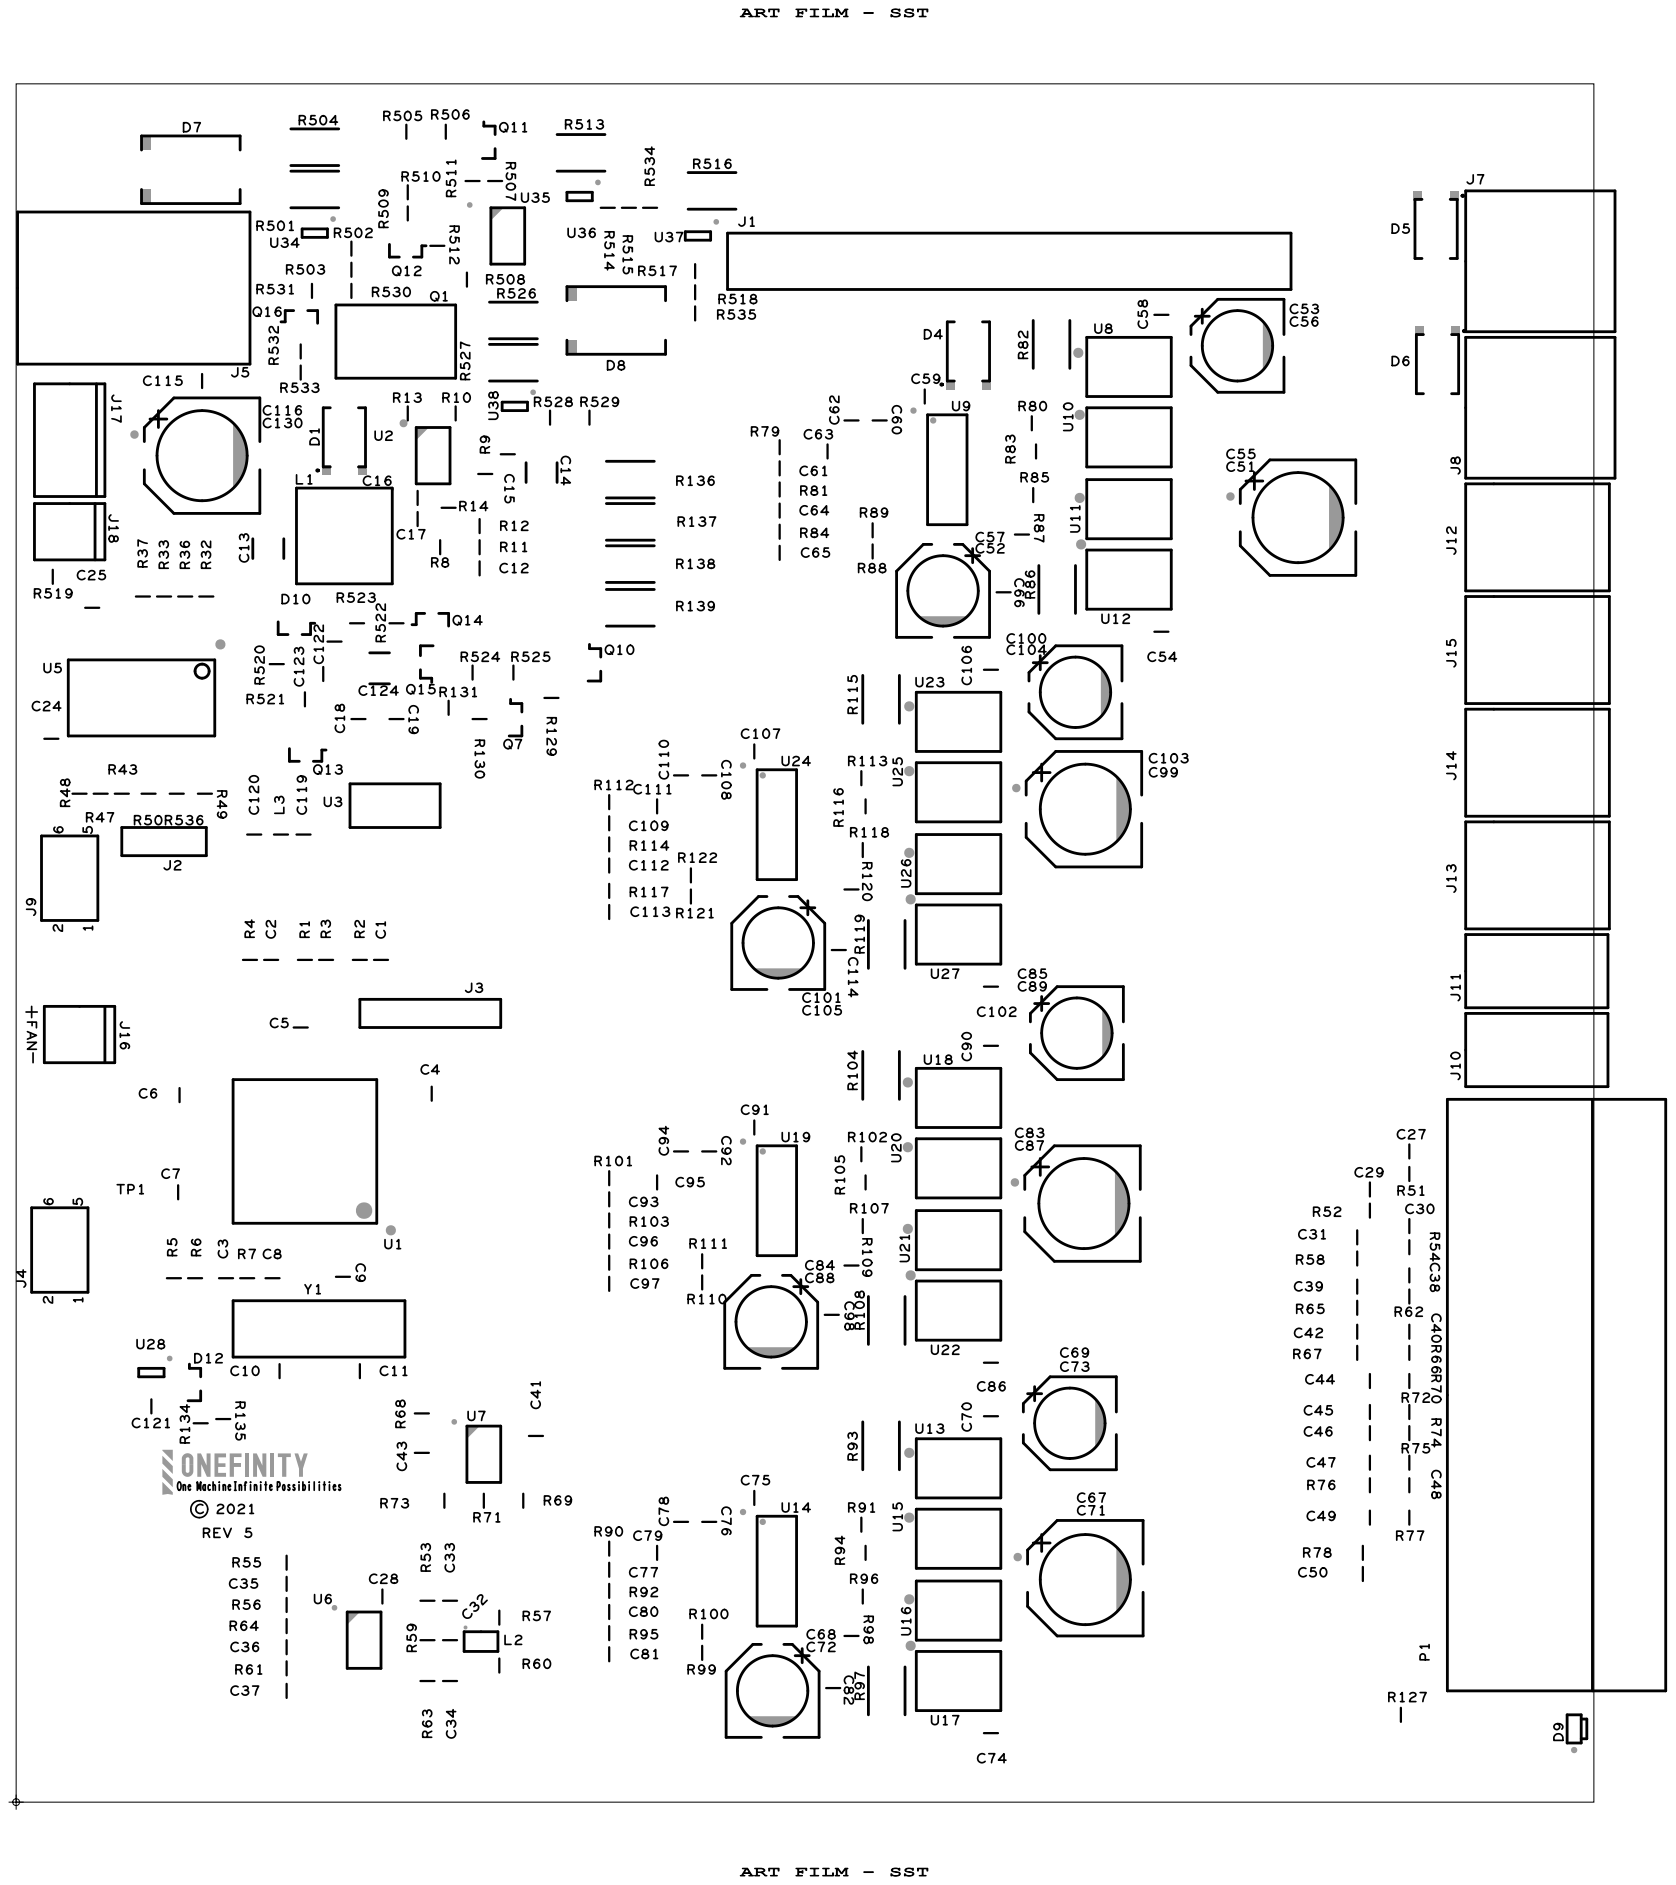
[picture p16: page 6]

## ART FILM - SMB

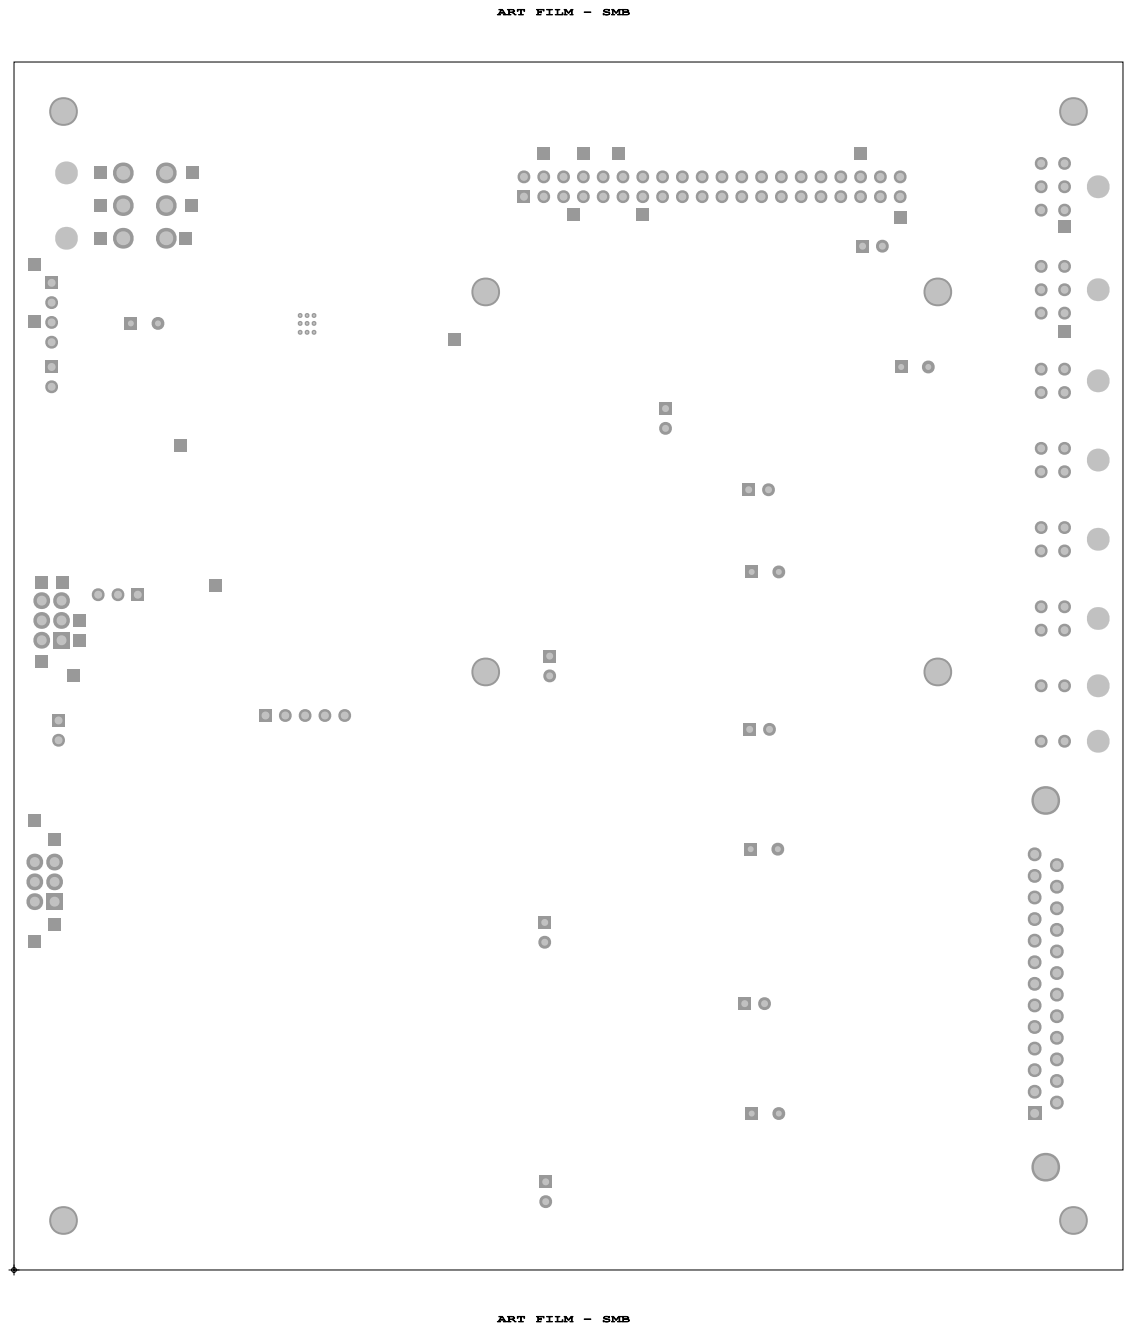
[picture p17: page 7]

ART FILM - SMB
