OneFinityCNC/onefinity-pcb/Schematics/onefinity-cnc-rev4.pdf

# DNI ¹

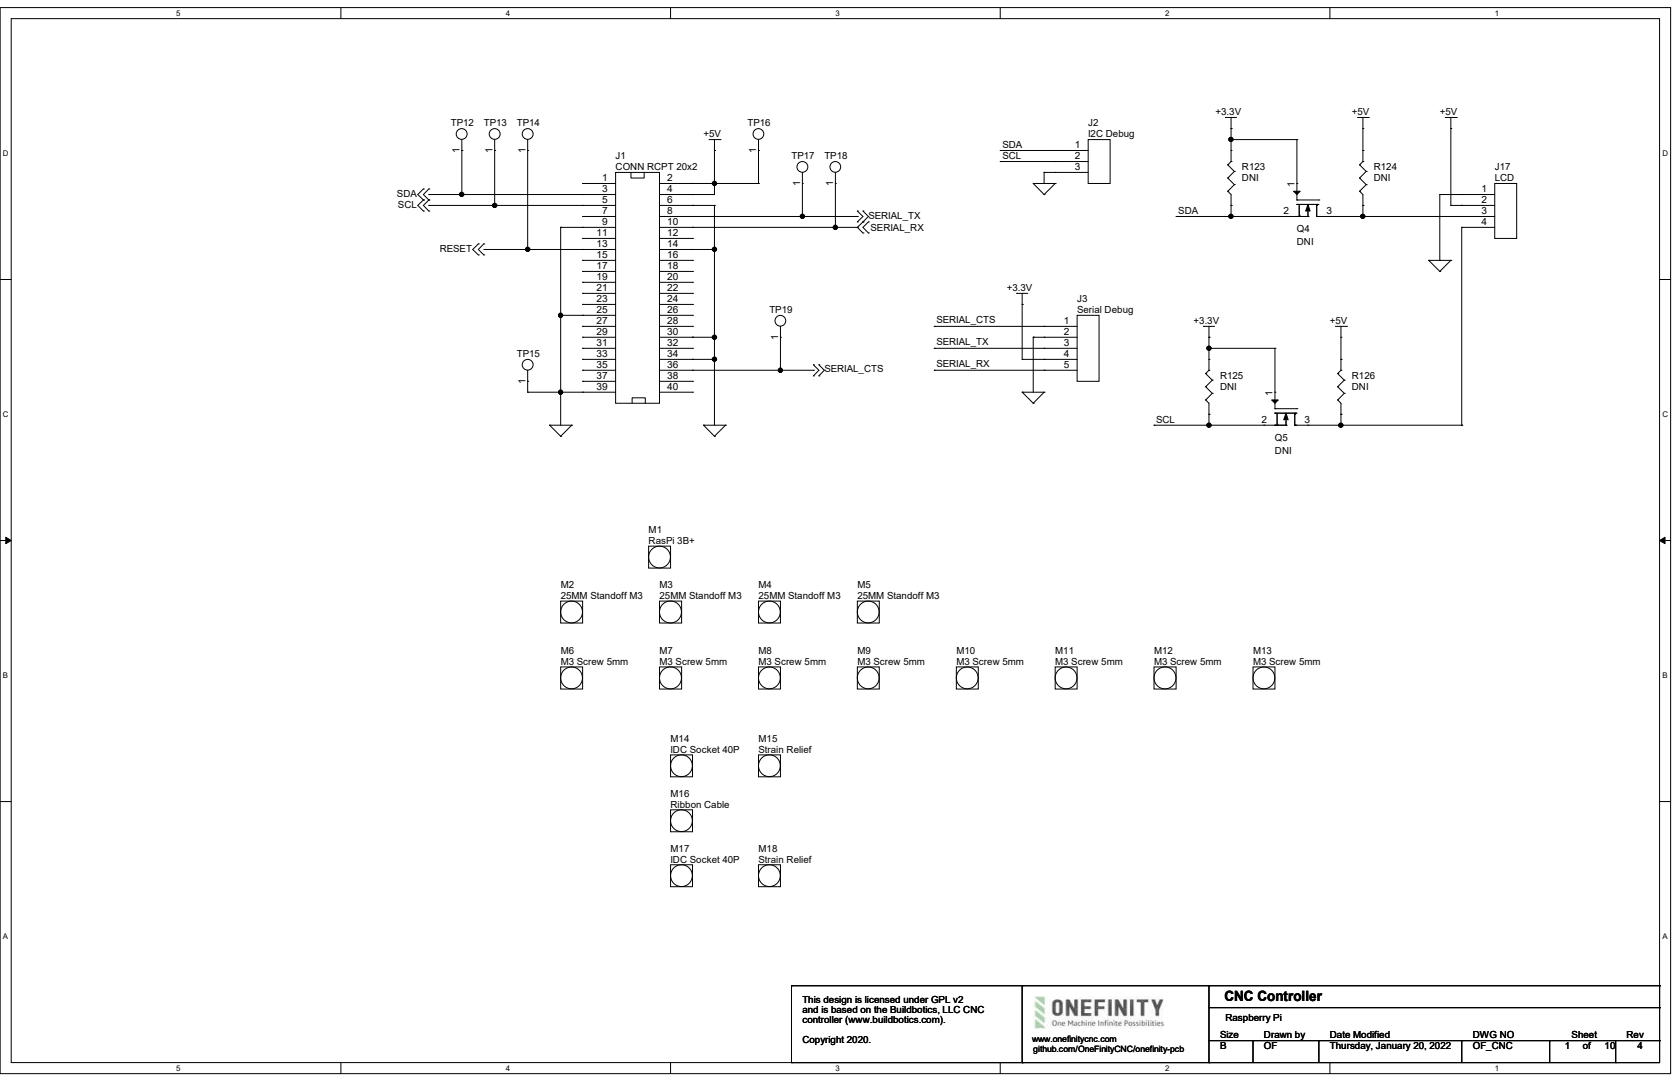
[picture p18: page 1]

This design is licensed under GPL v2
and is based on the Buildbotics, LLC CNC
controller (www.buildbotics.com).

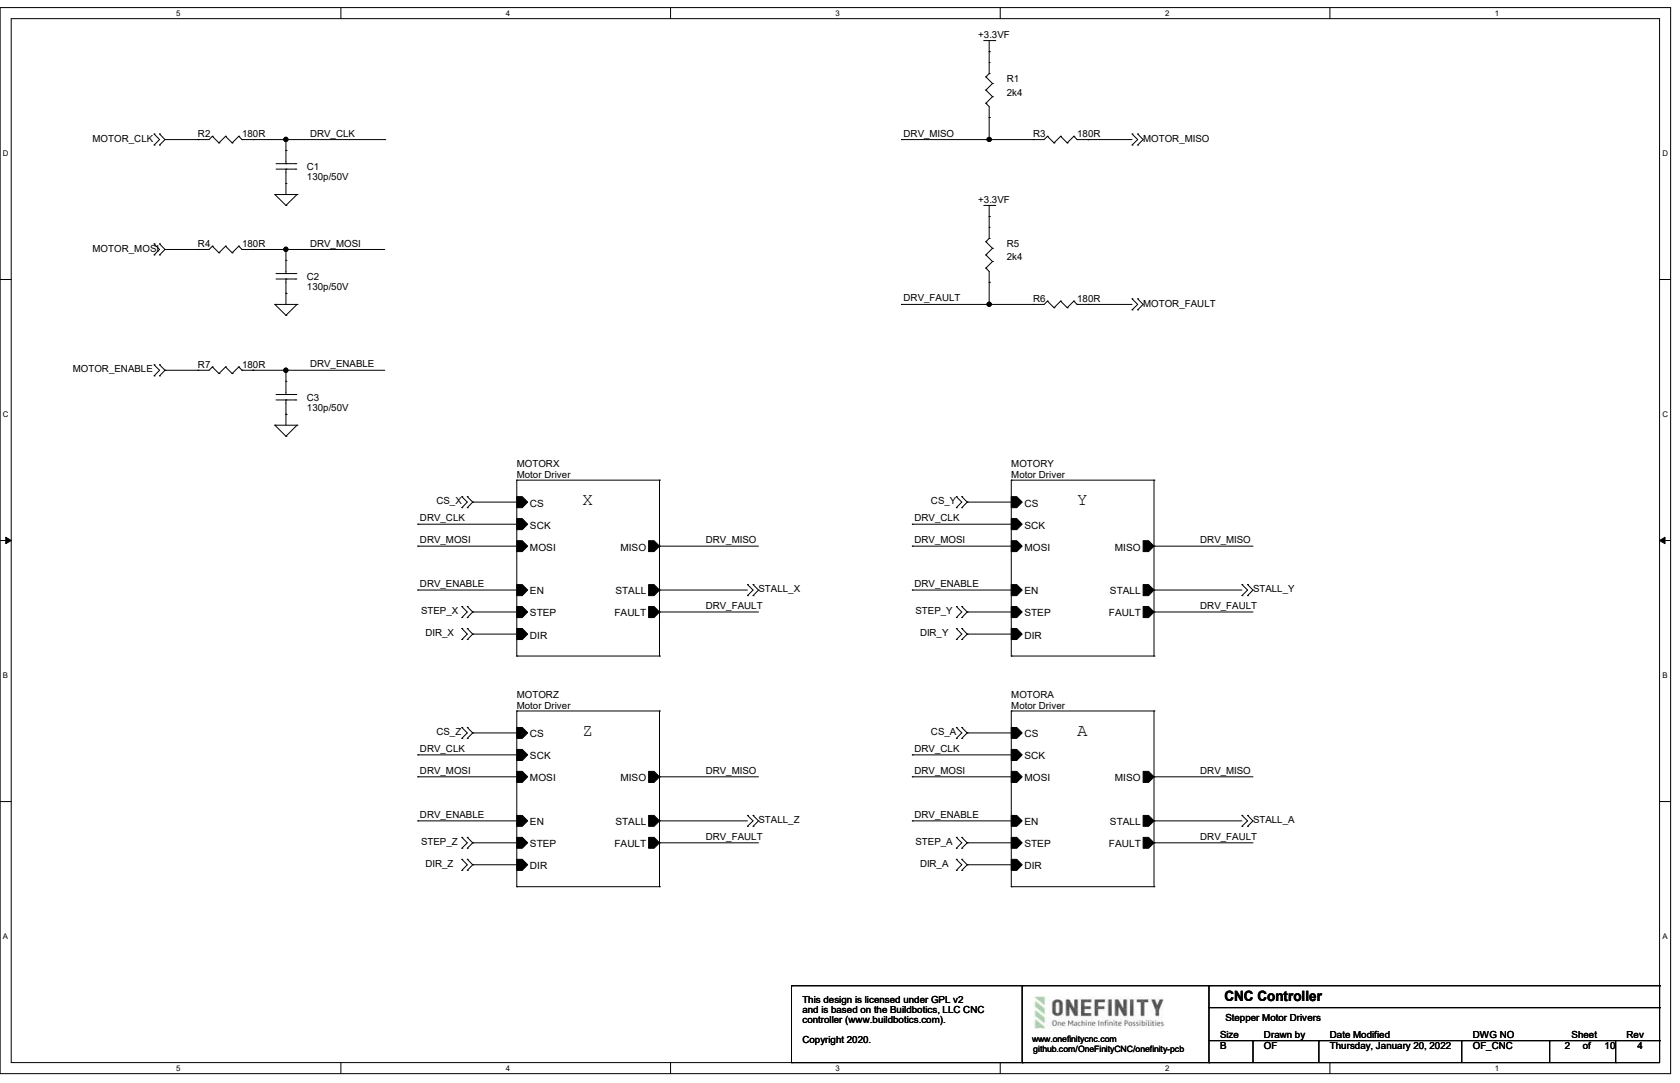
[picture p19: page 2]

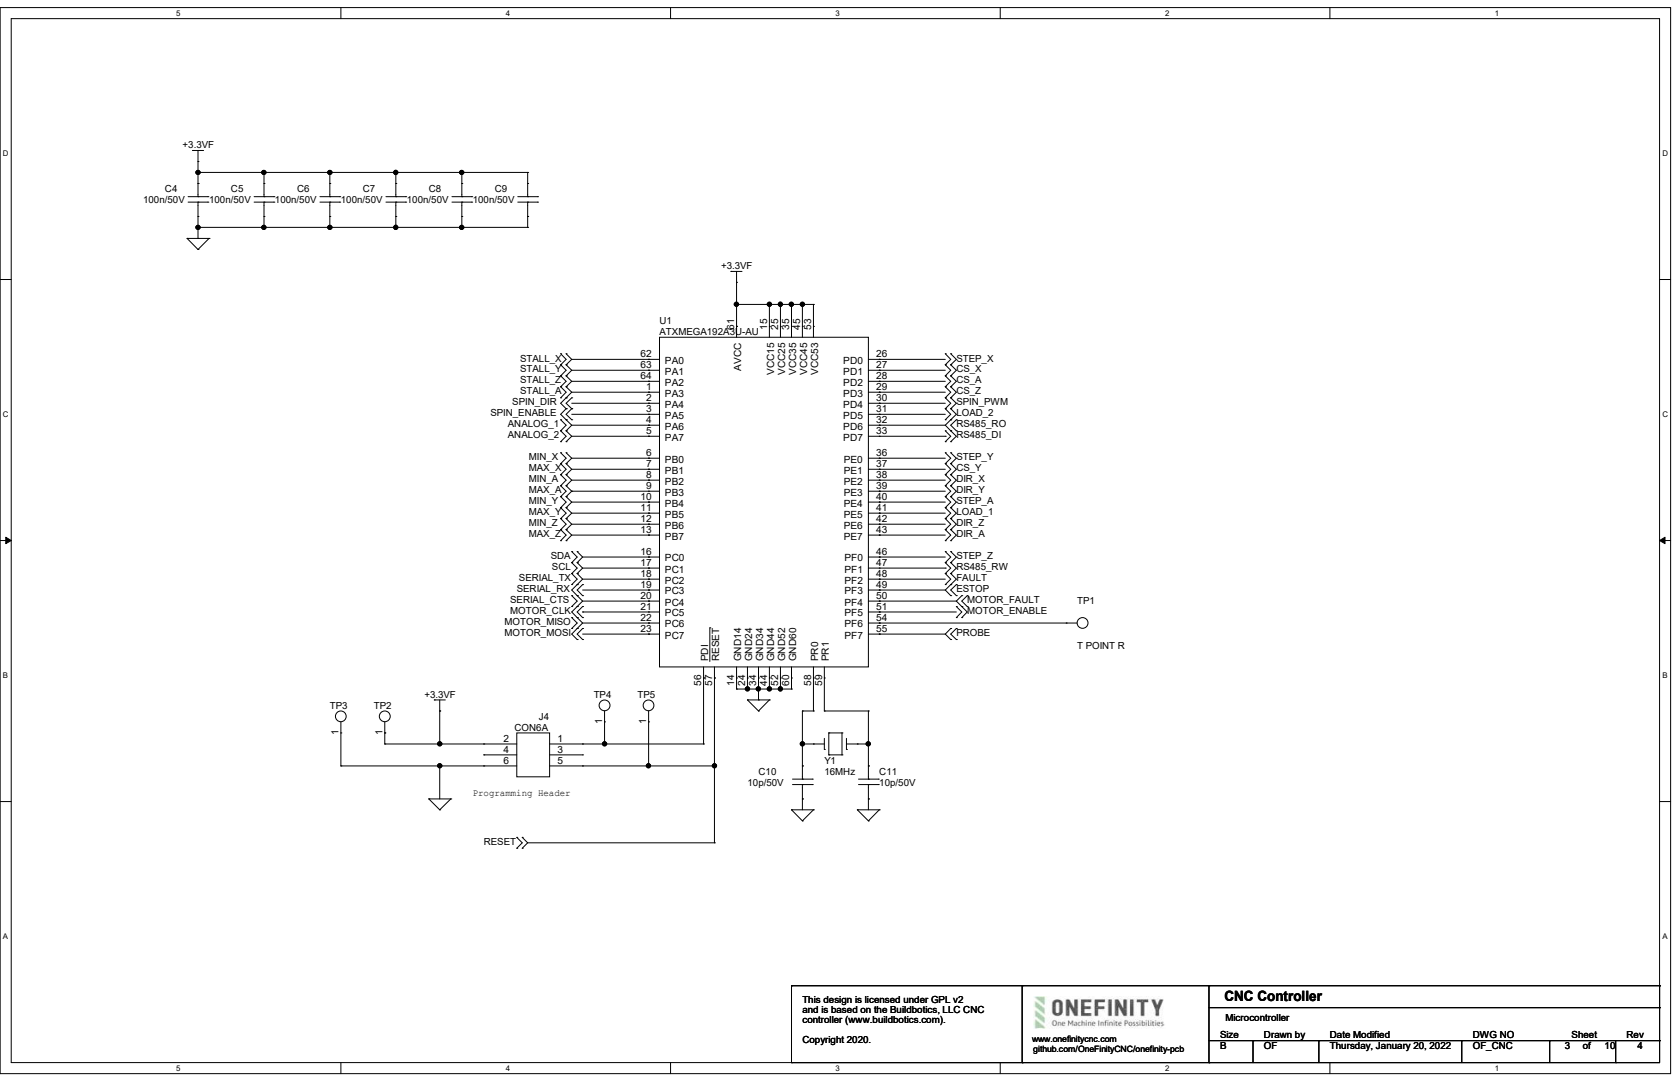
[picture p20: page 3]

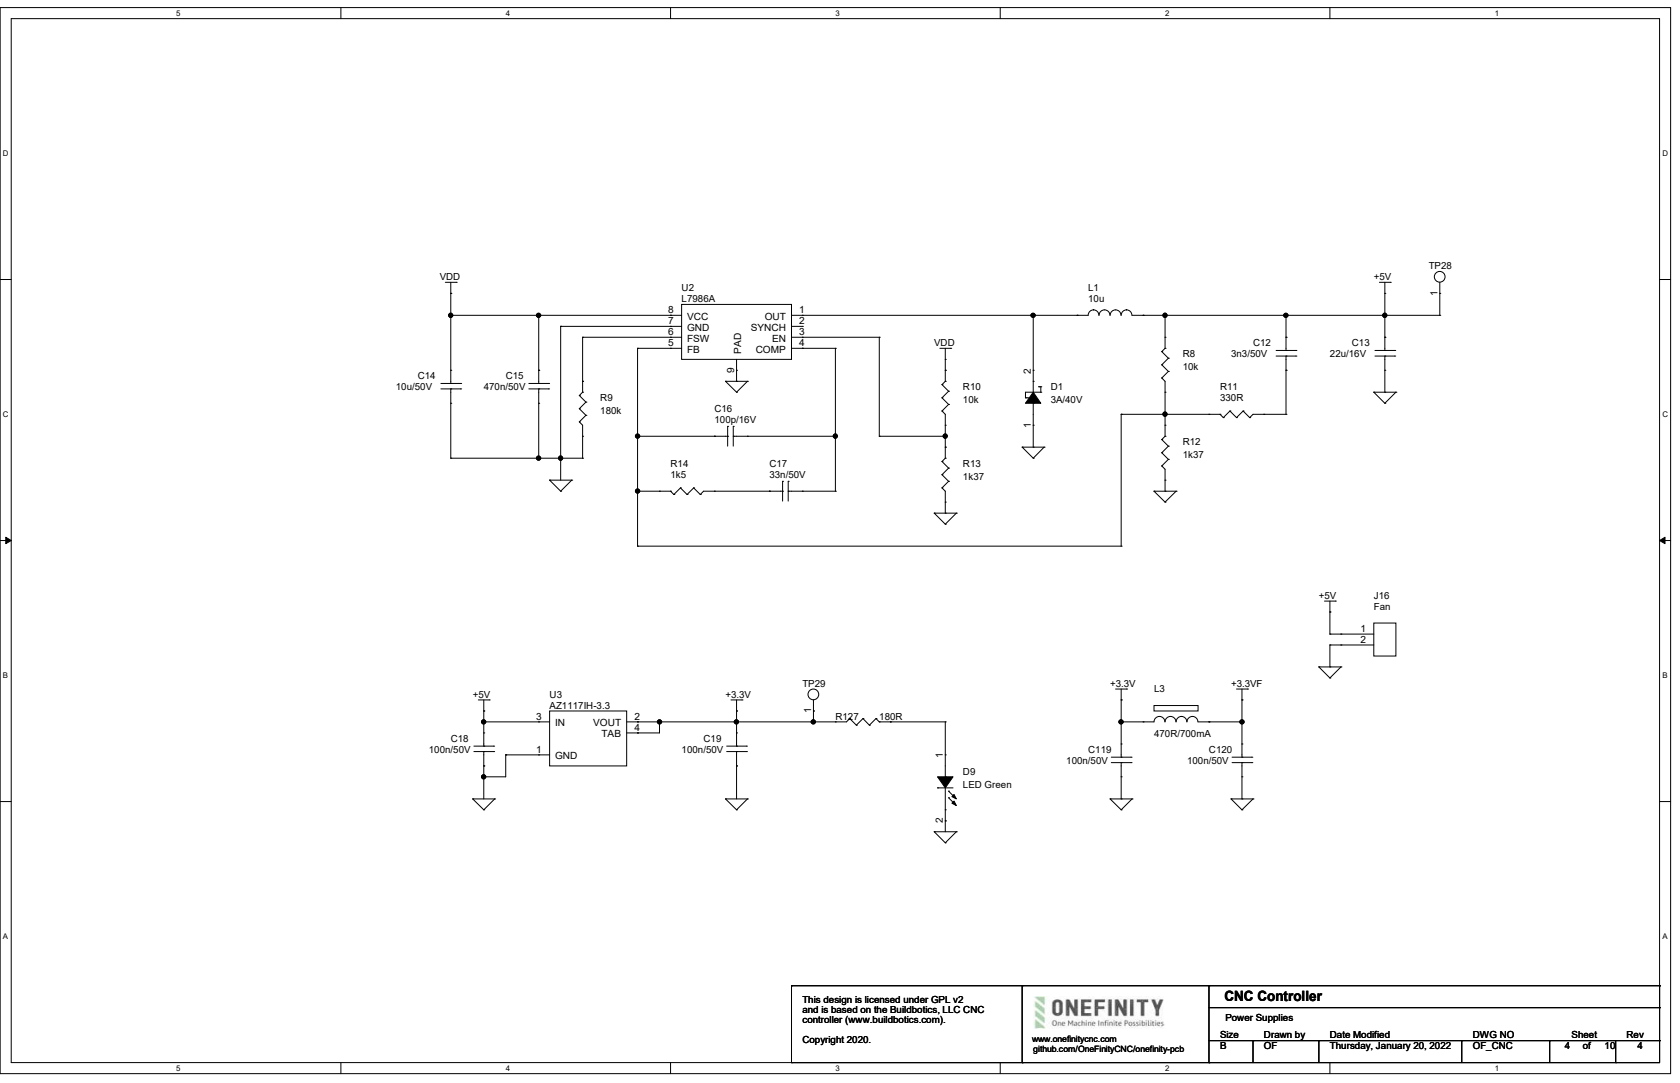
[picture p21: page 4]

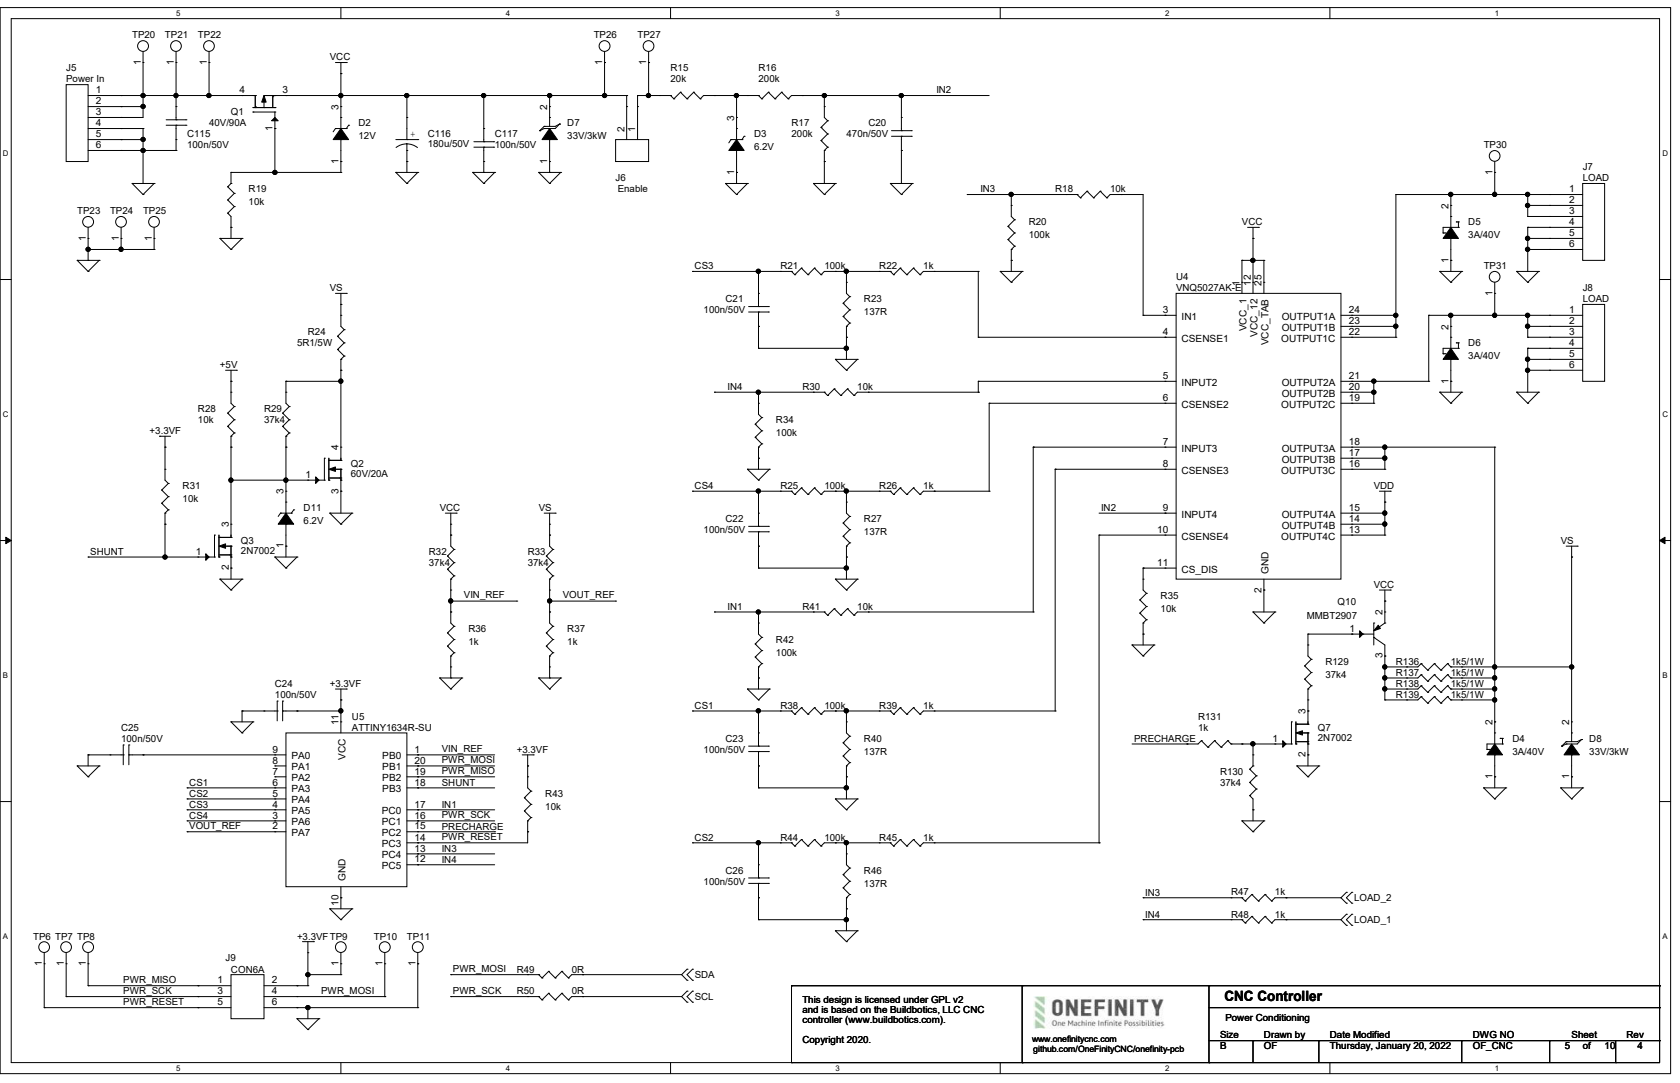
[picture p22: page 5]

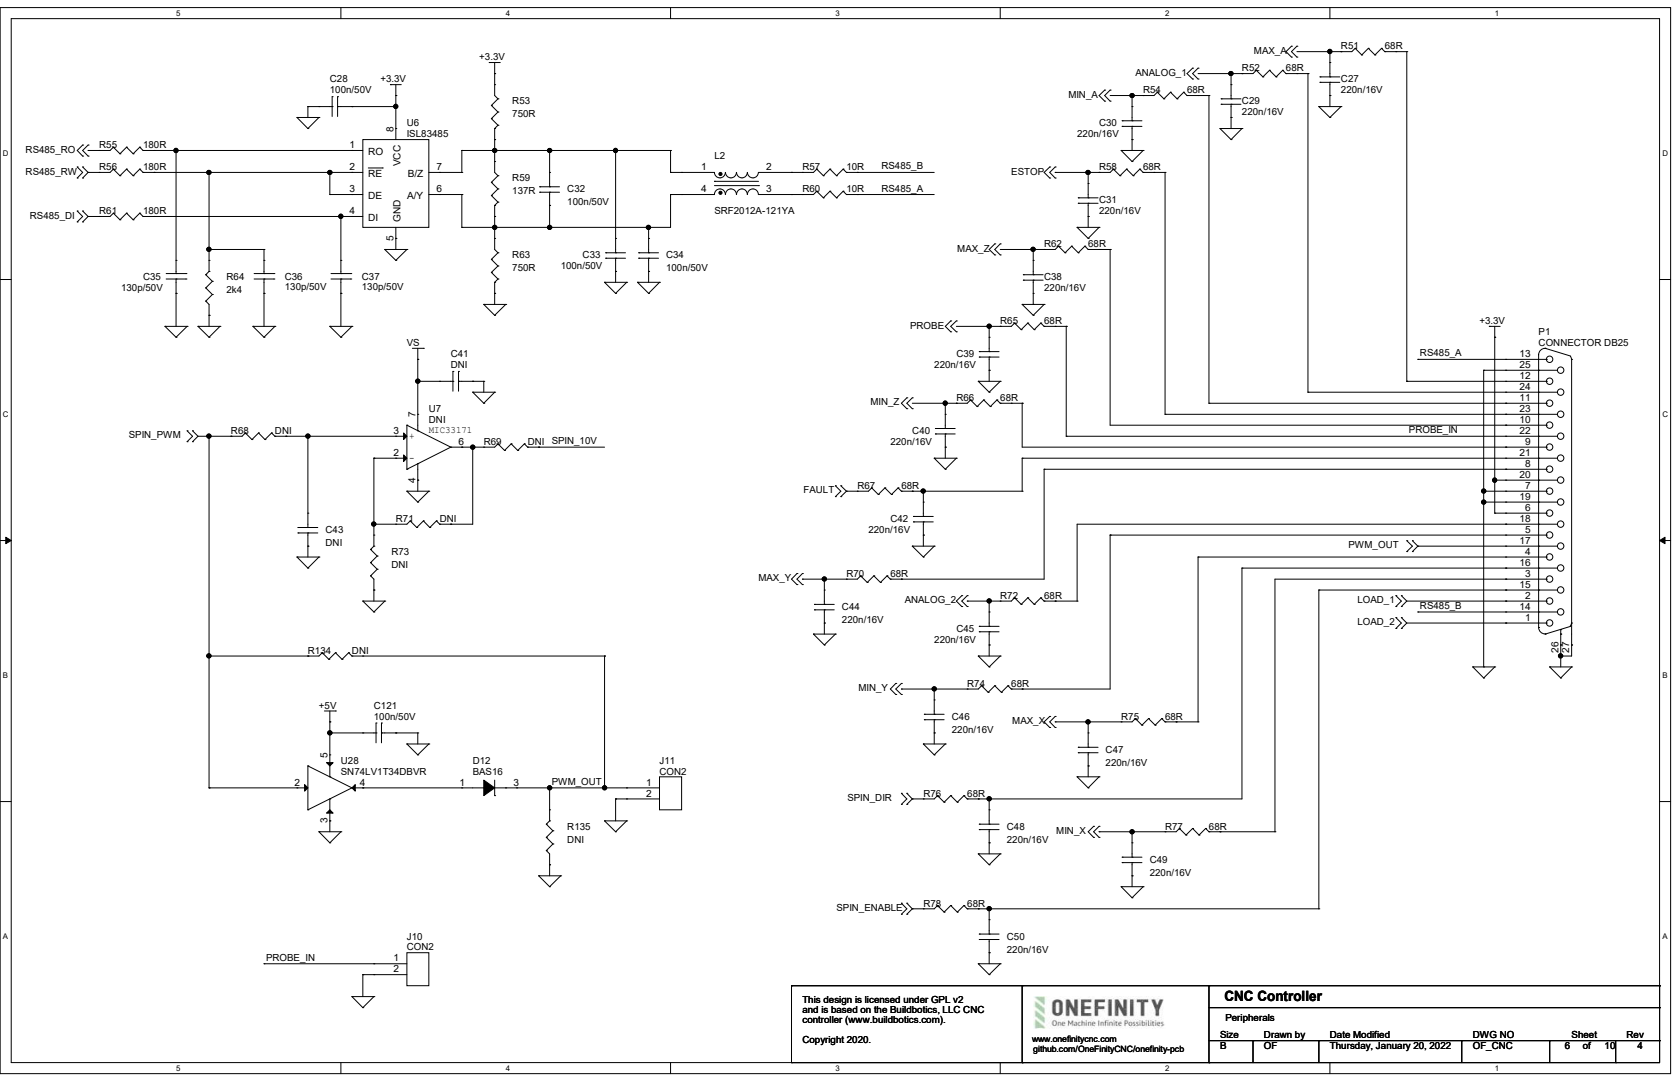
[picture p23: page 6]

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
PWM_OUT | 17 4

16
15

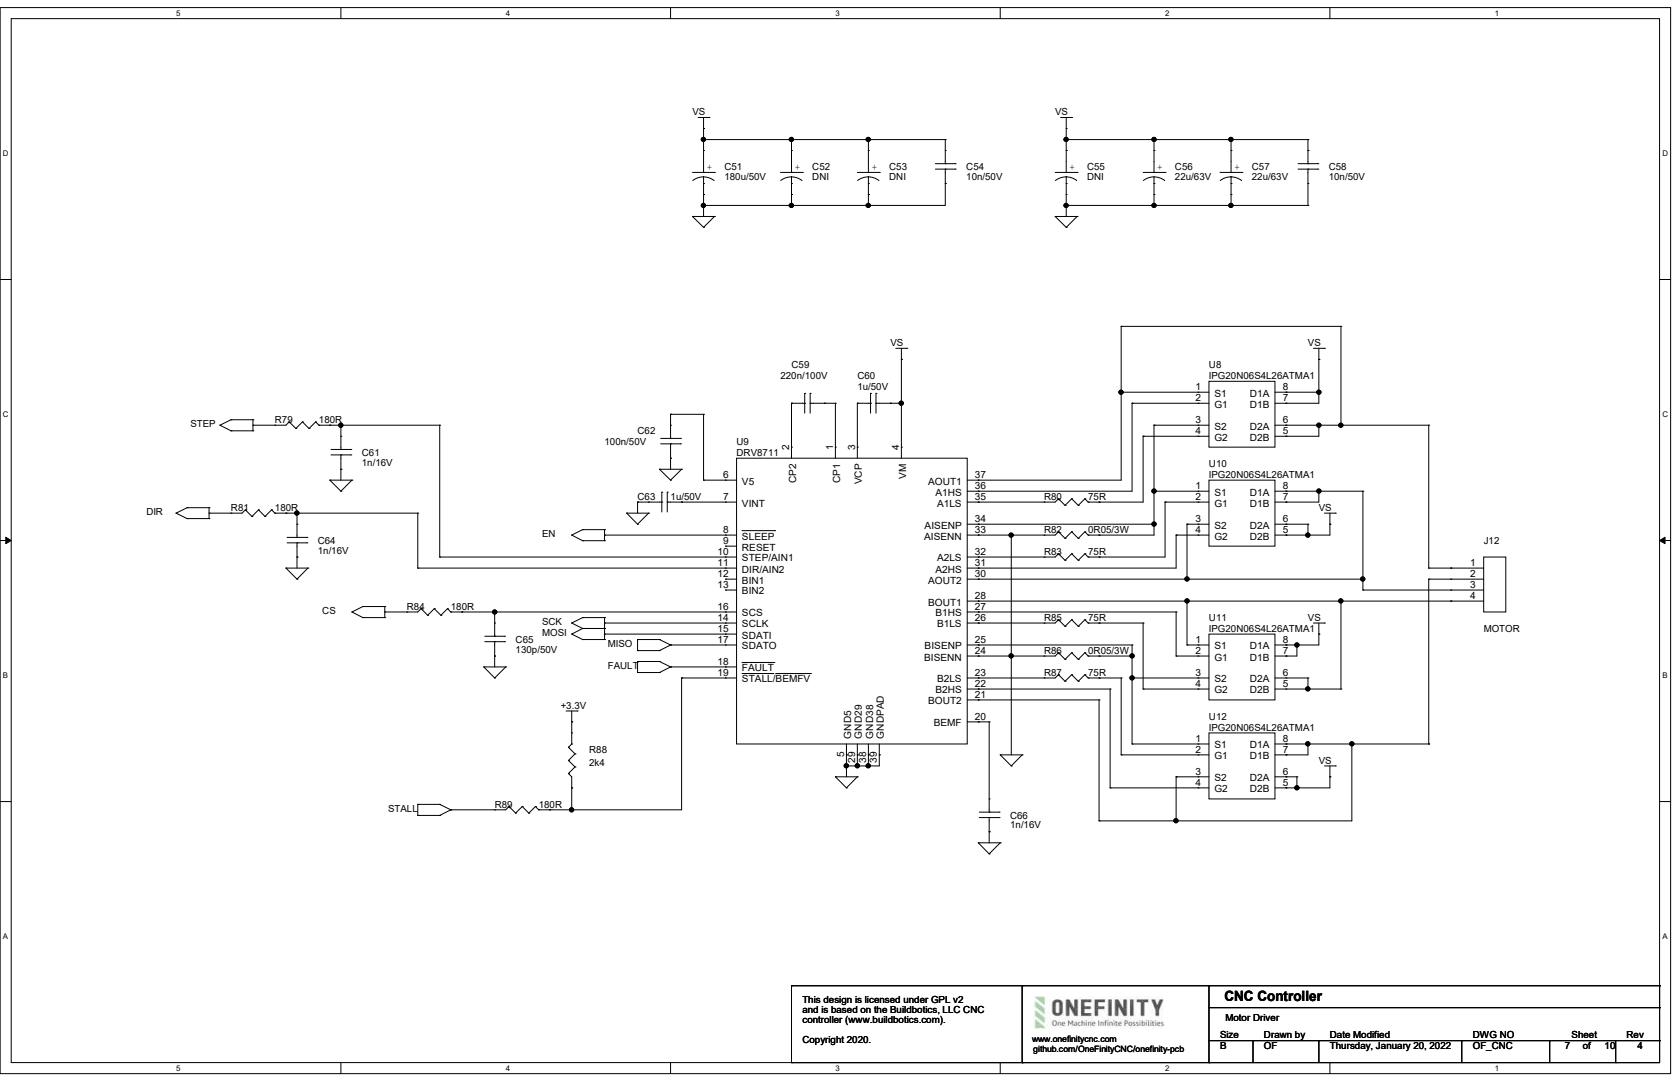
[picture p24: page 7]

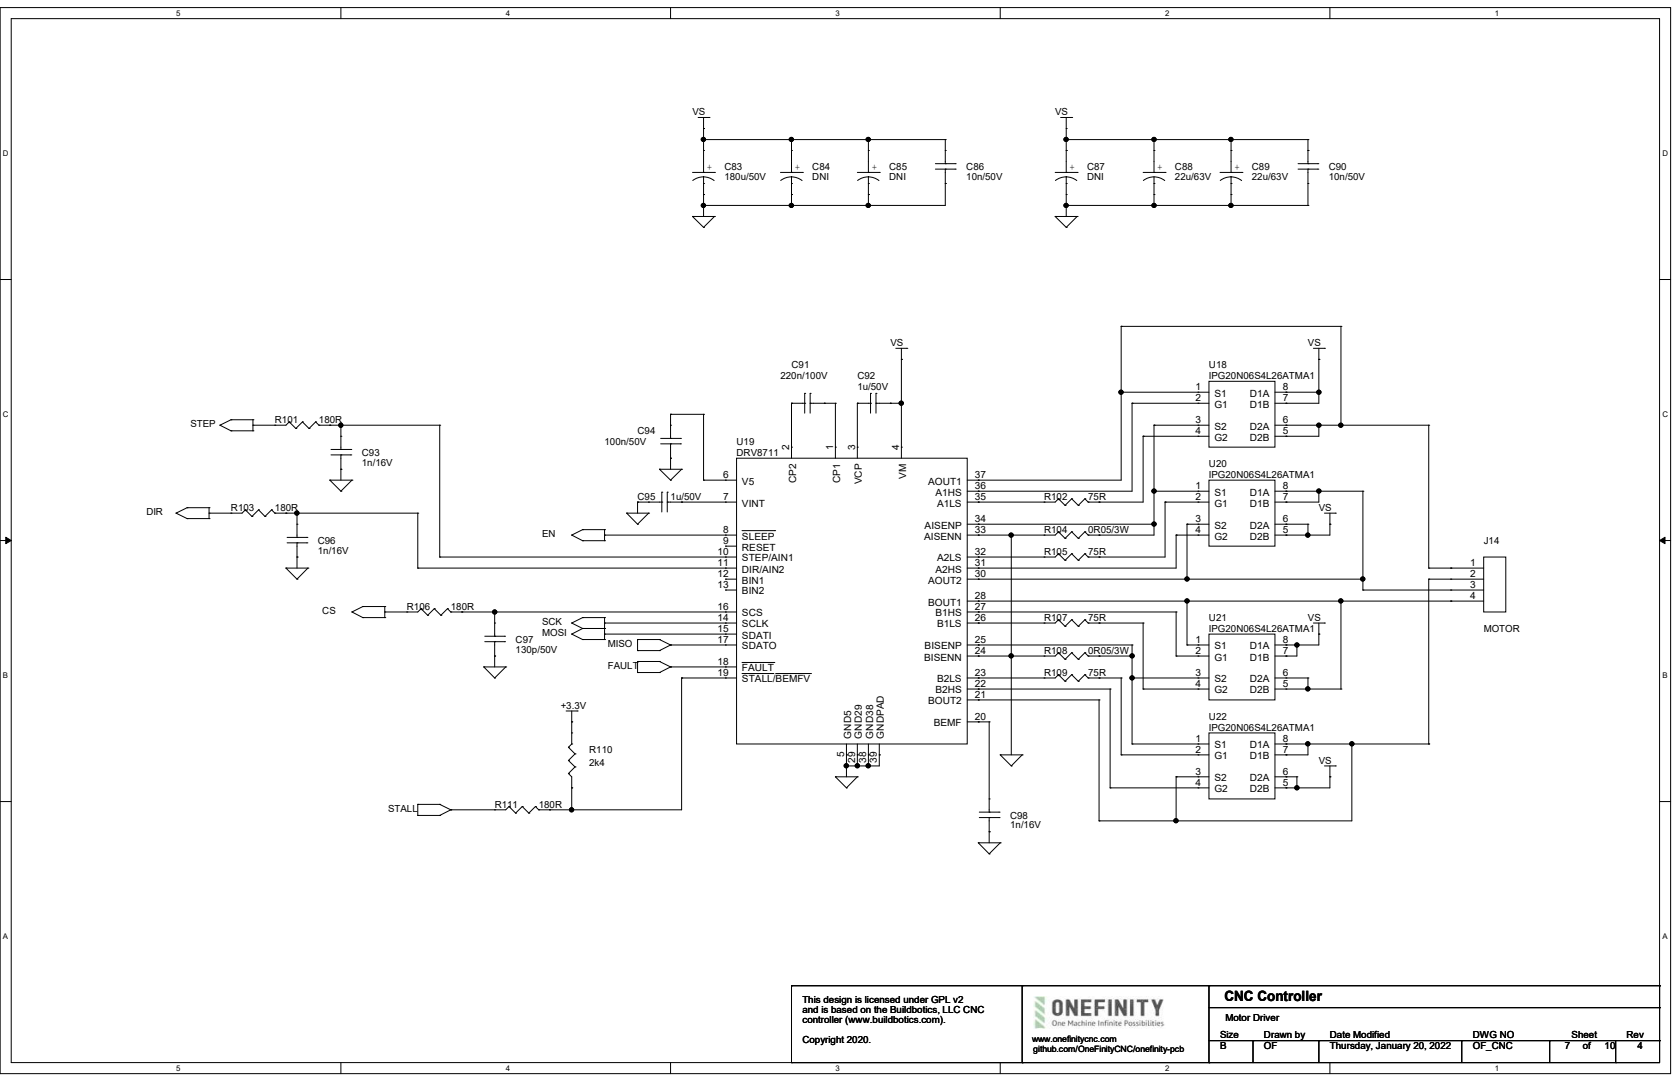
[picture p25: page 8]

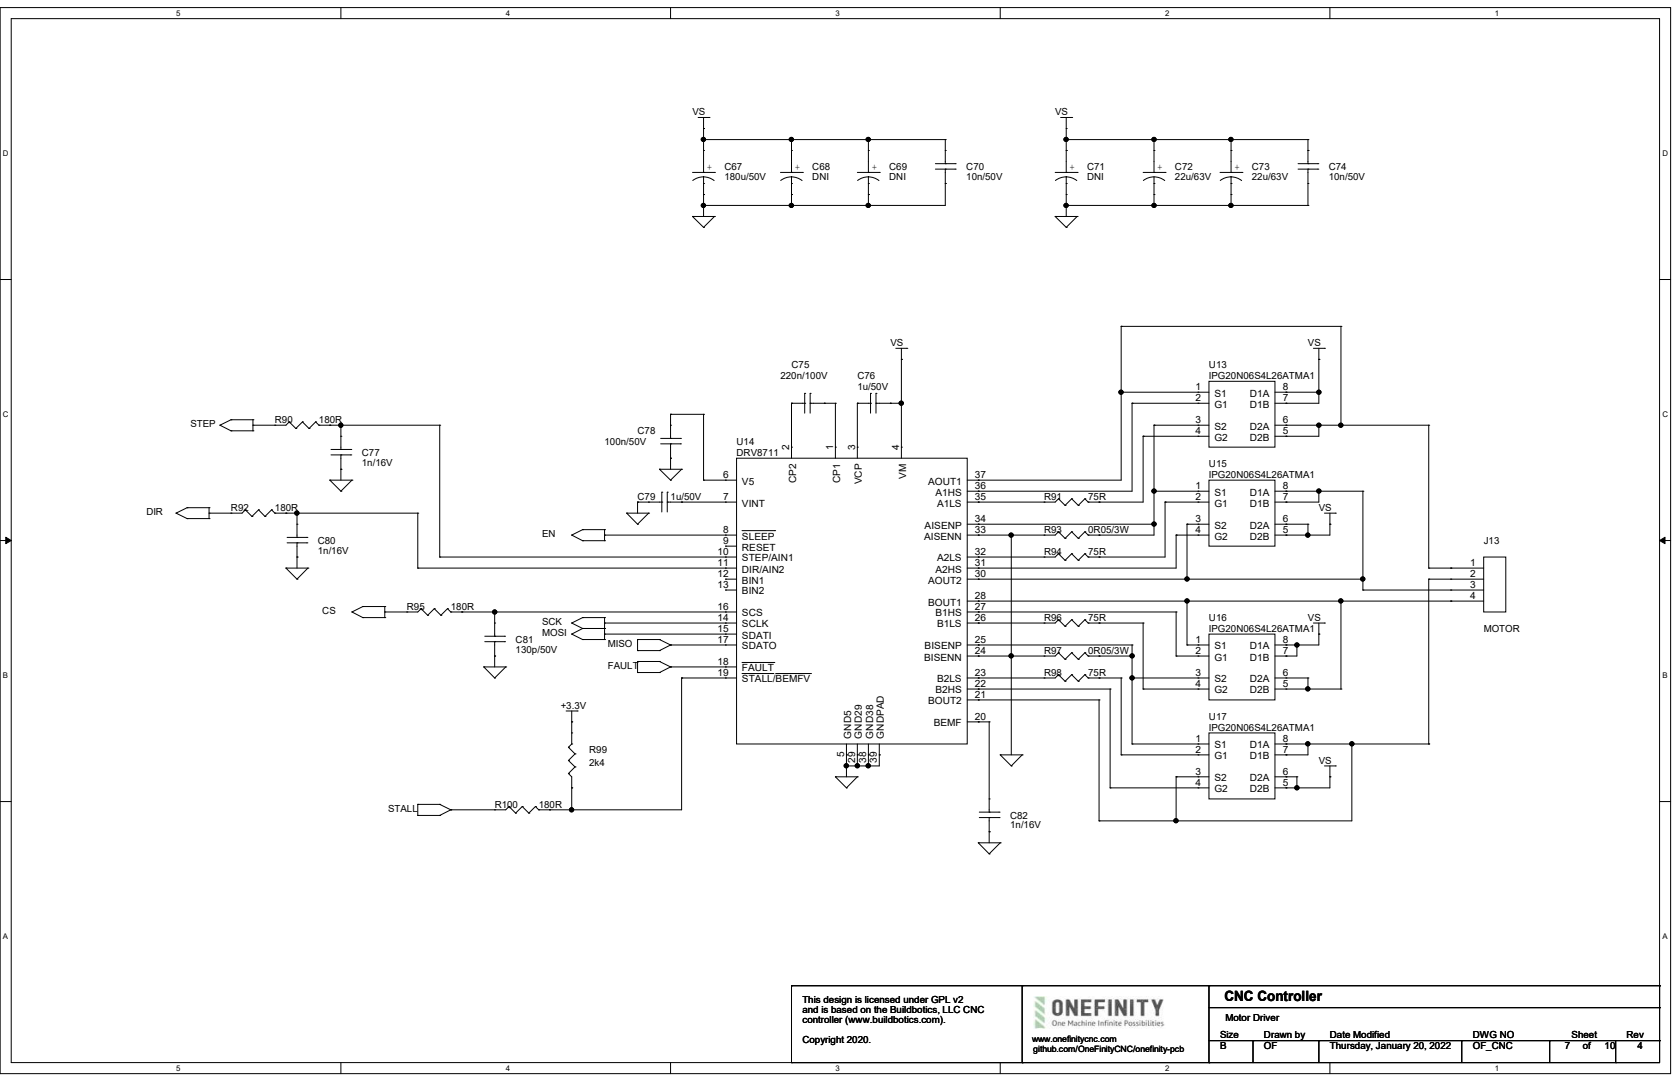
[picture p26: page 9]

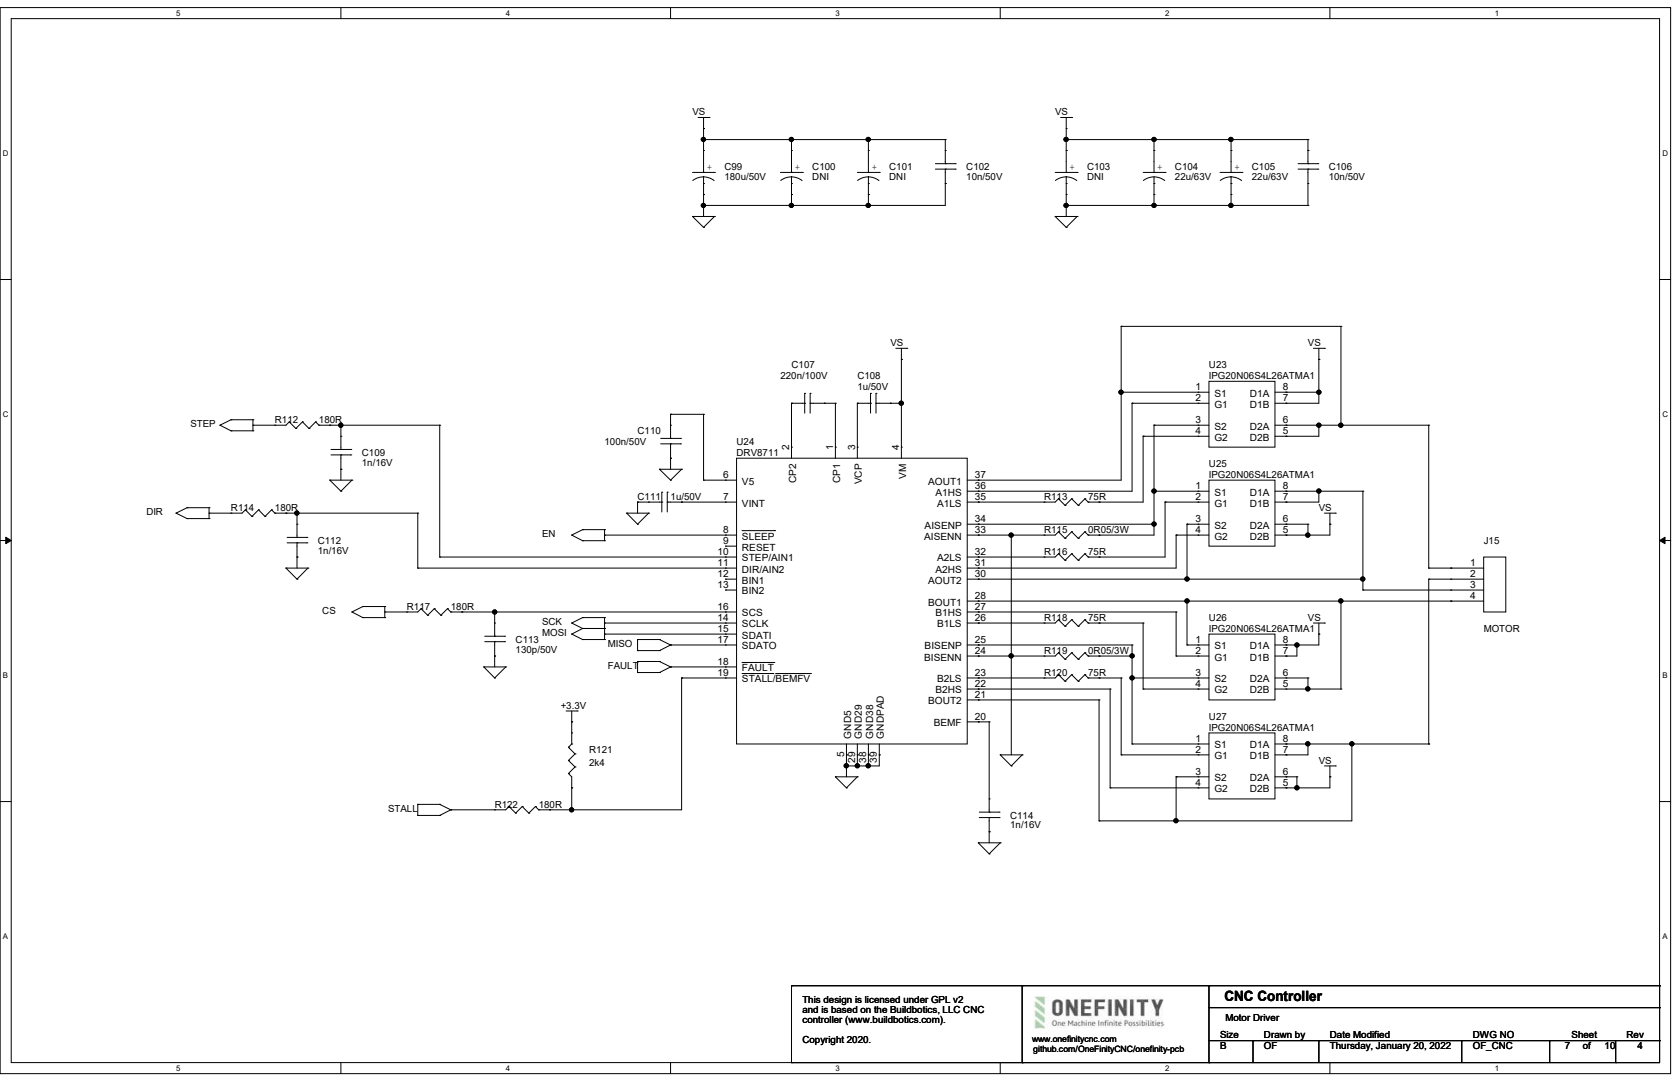
[picture p27: page 10]
