OneFinityCNC/onefinity-pcb/Gerber/controller-gerber-rev4.pdf

## ART FILM - TOP

D3 Q1

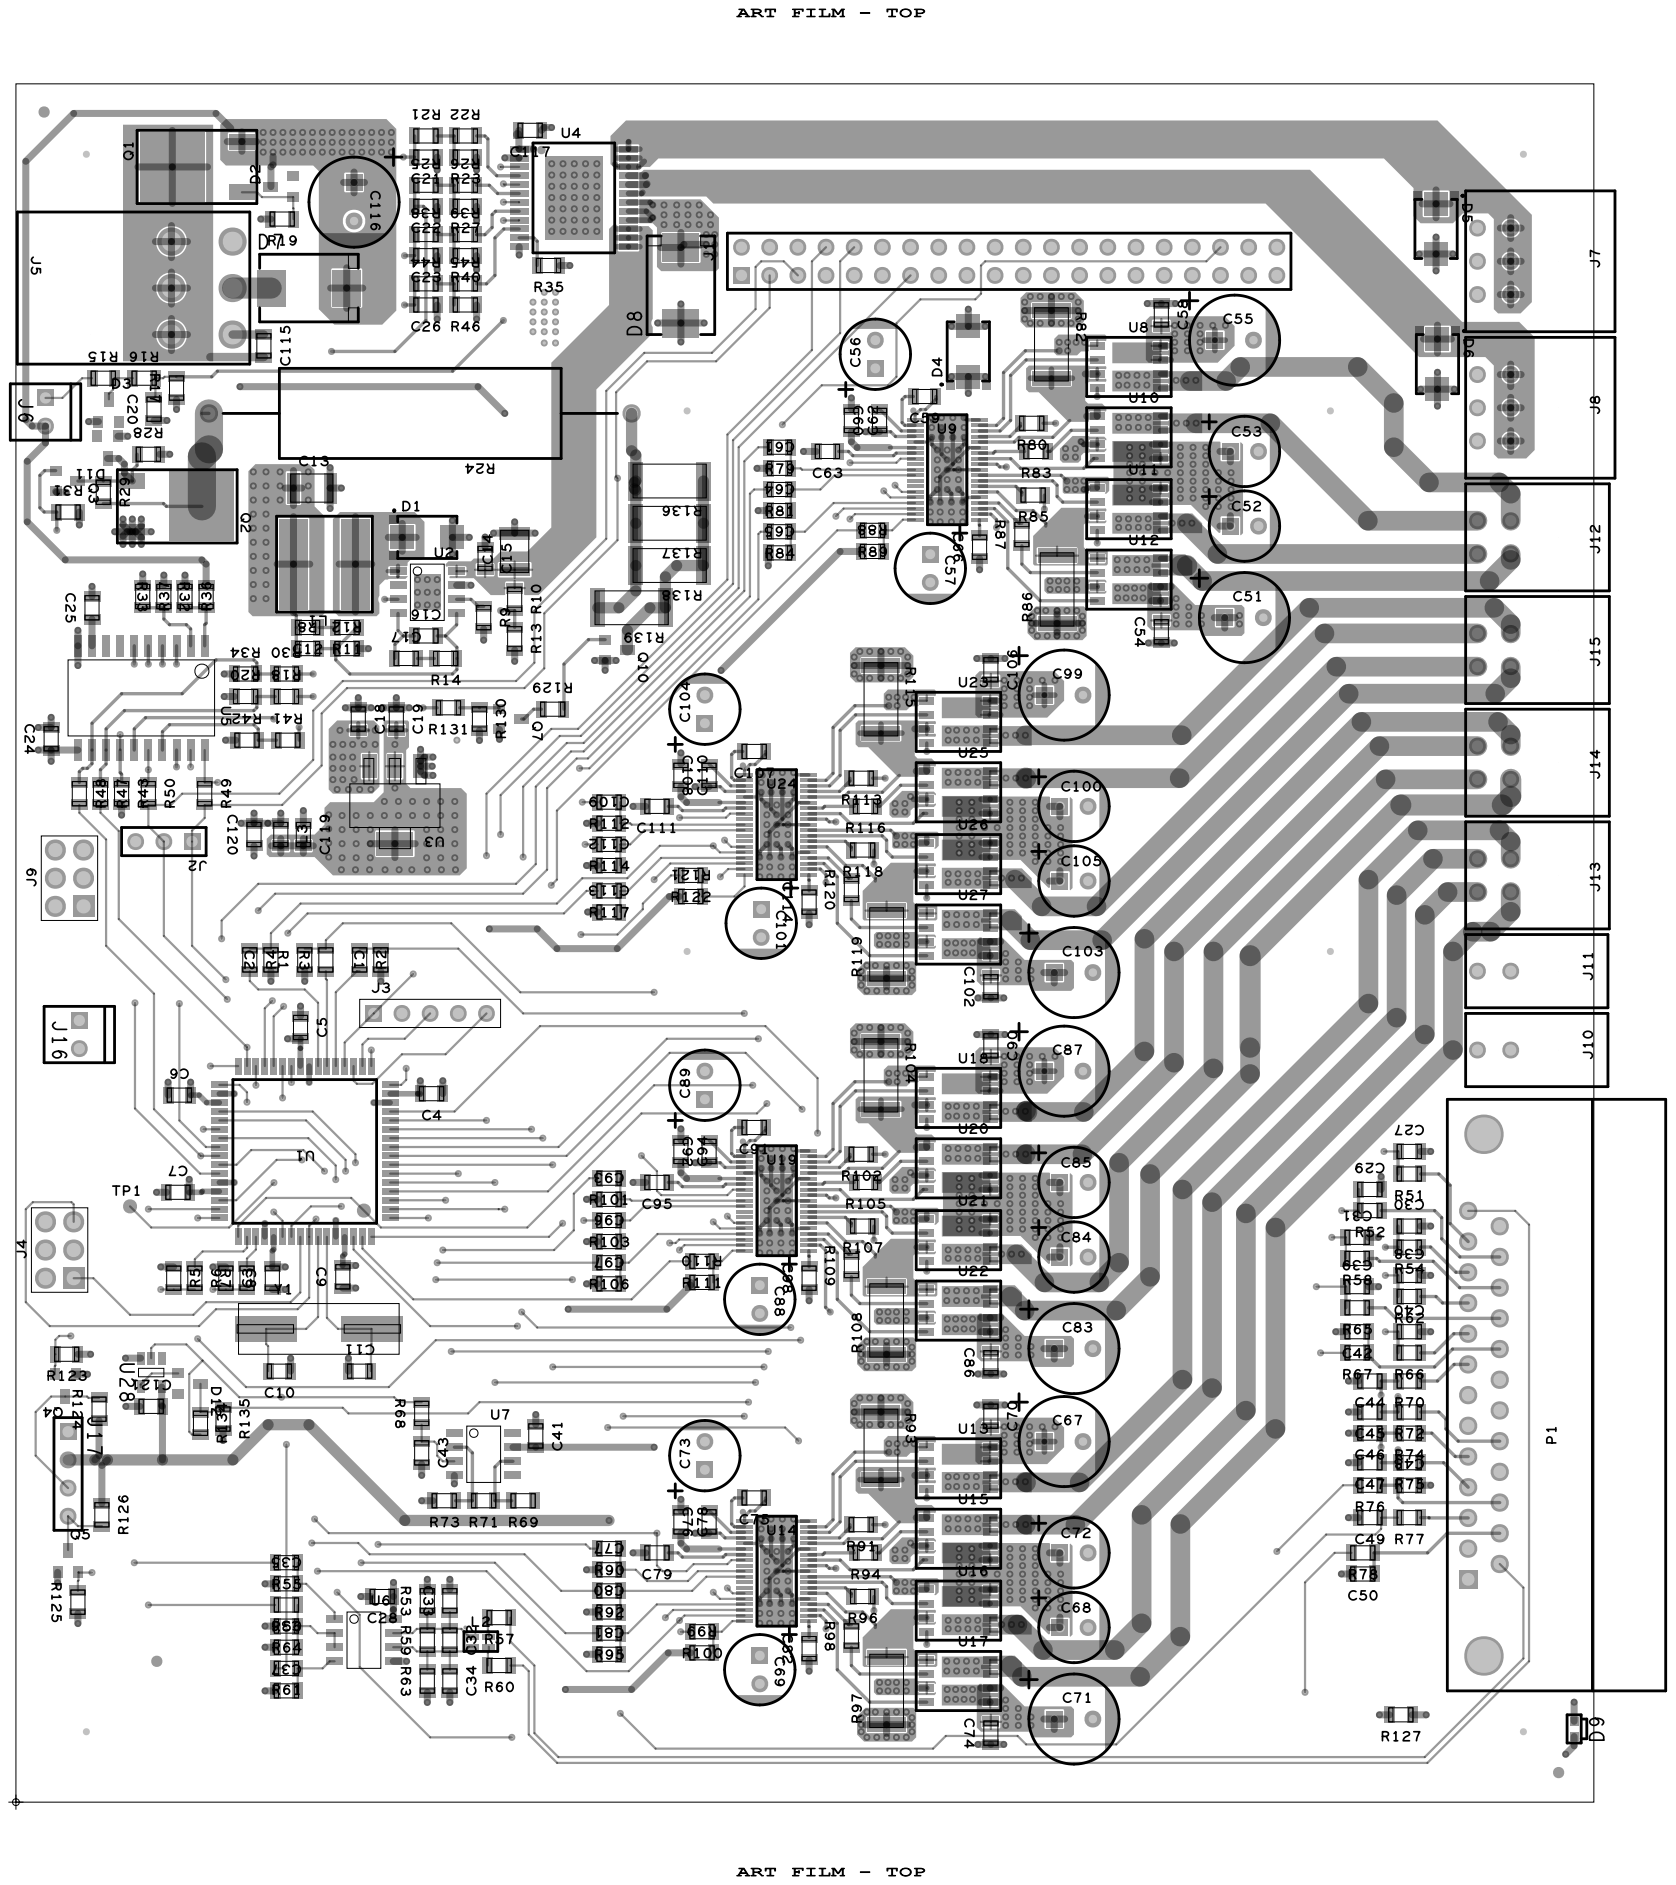
[picture p28: page 1]

## ART FILM - GND

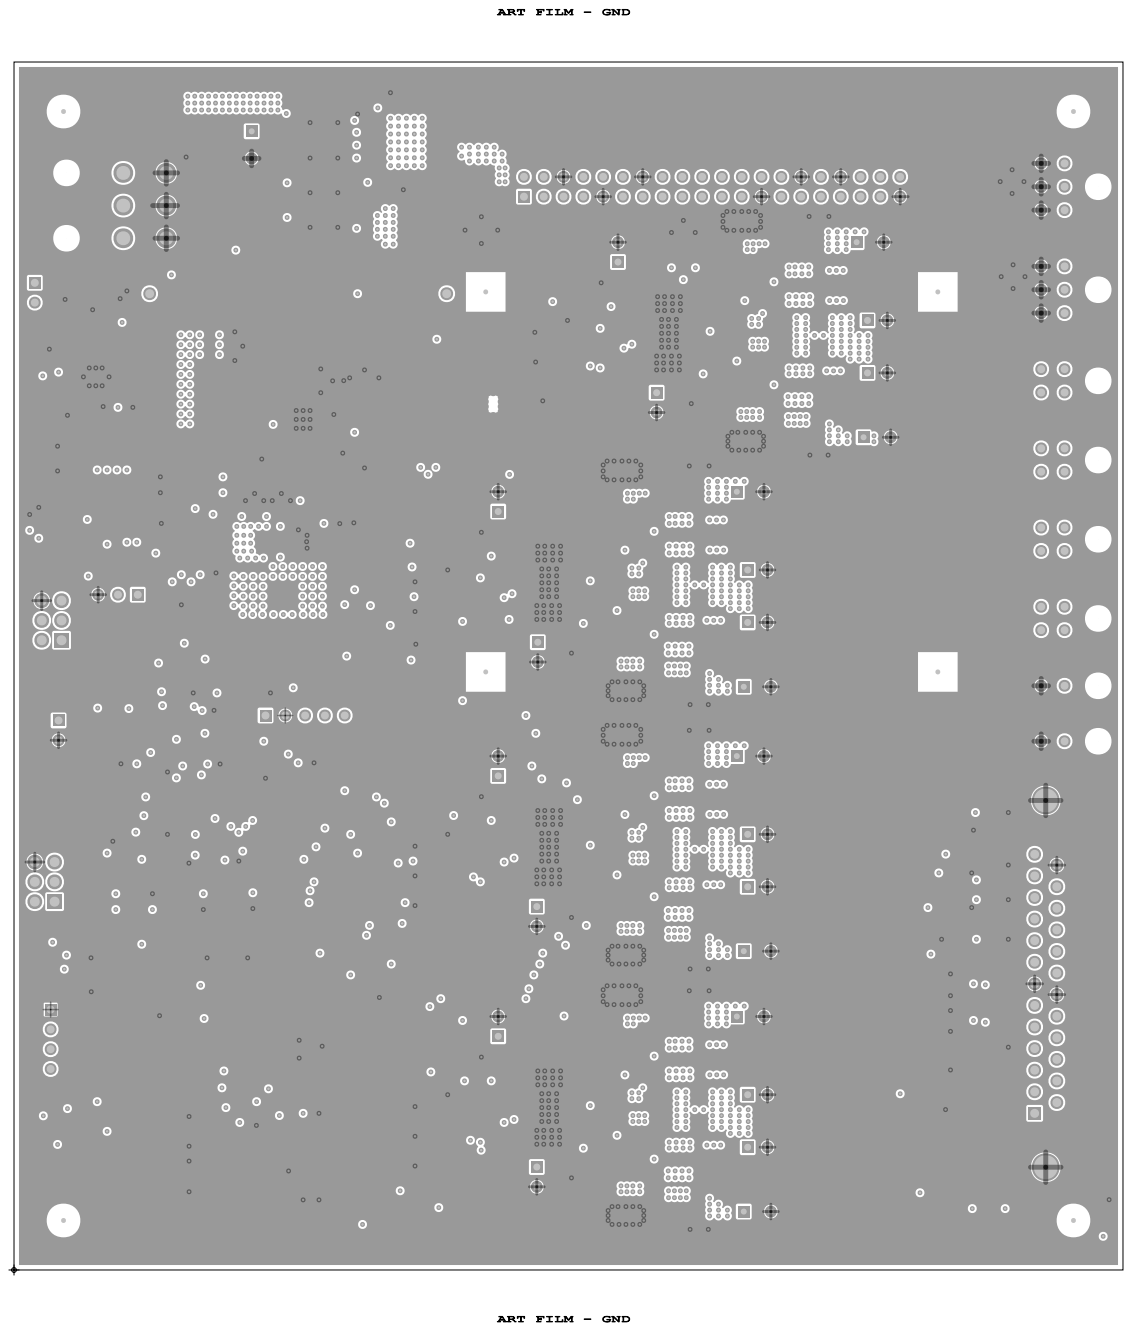
[picture p29: page 2]

ART FILM - GND

## ART FILM - PWR

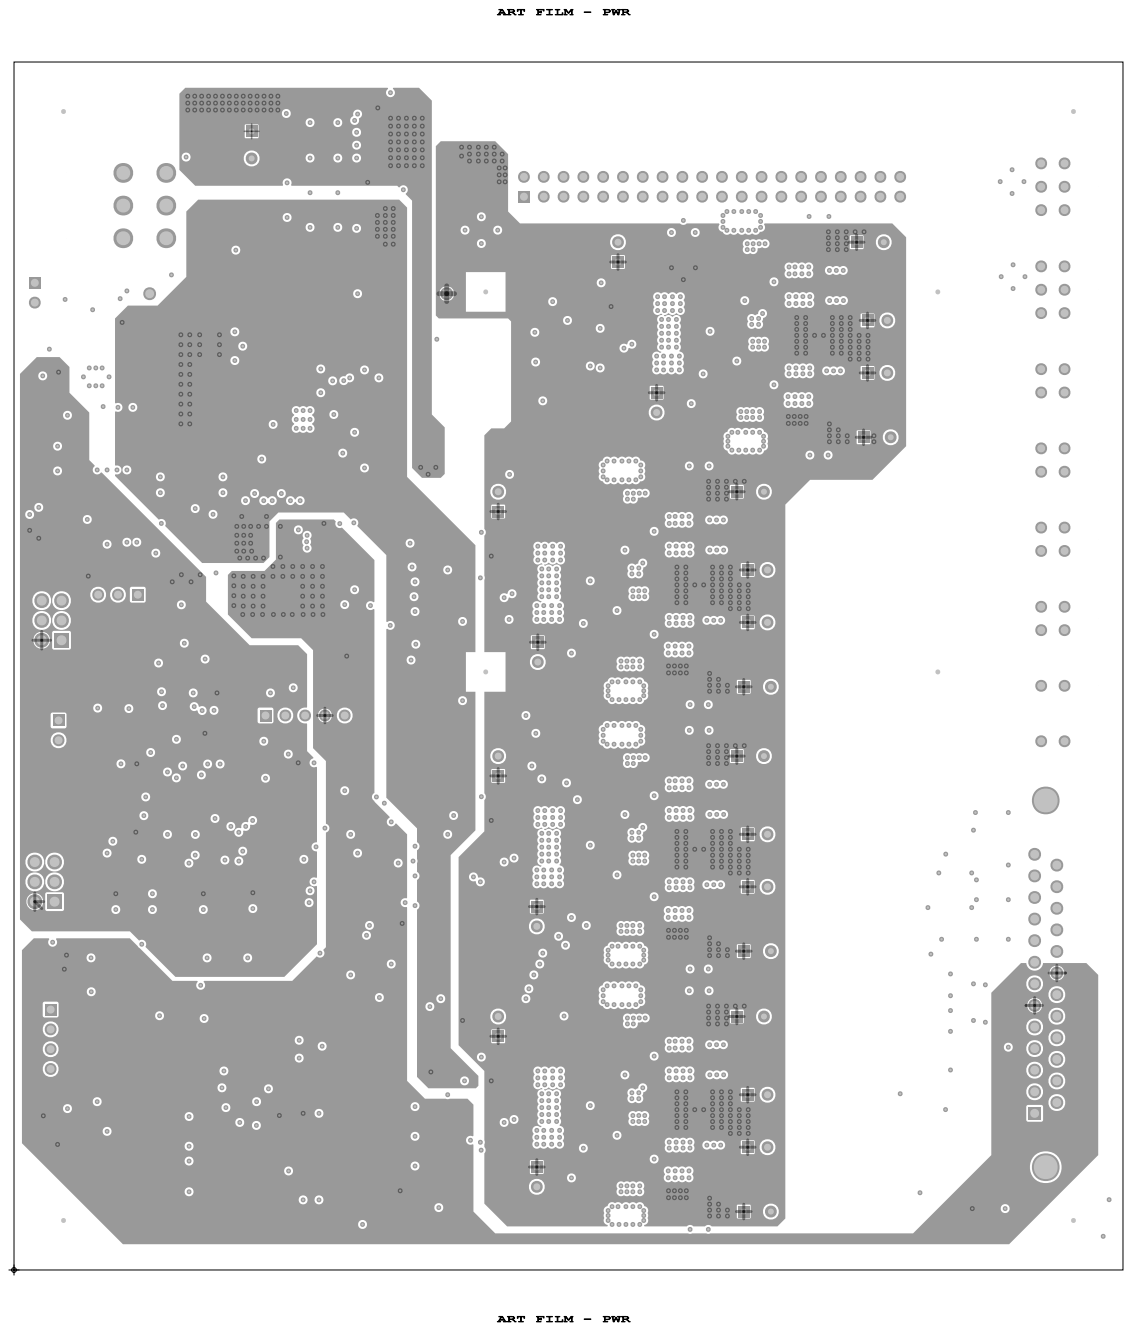
[picture p30: page 3]

ART FILM - PWR

## ART FILM - BOTTOM

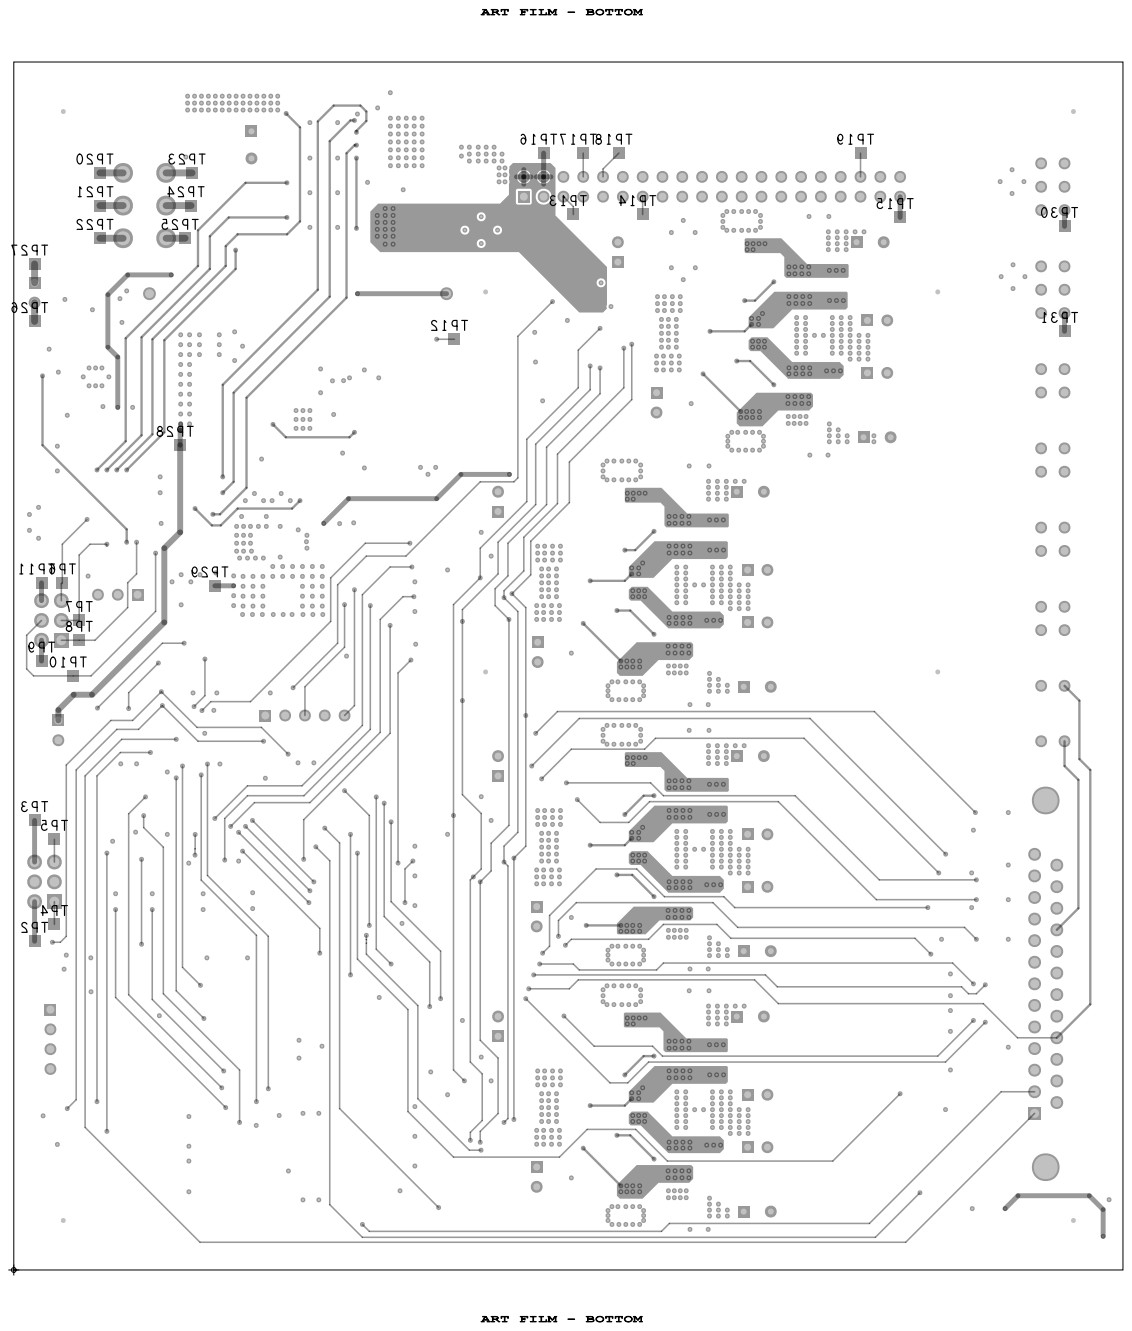
[picture p31: page 4]

## ART FILM - SMT

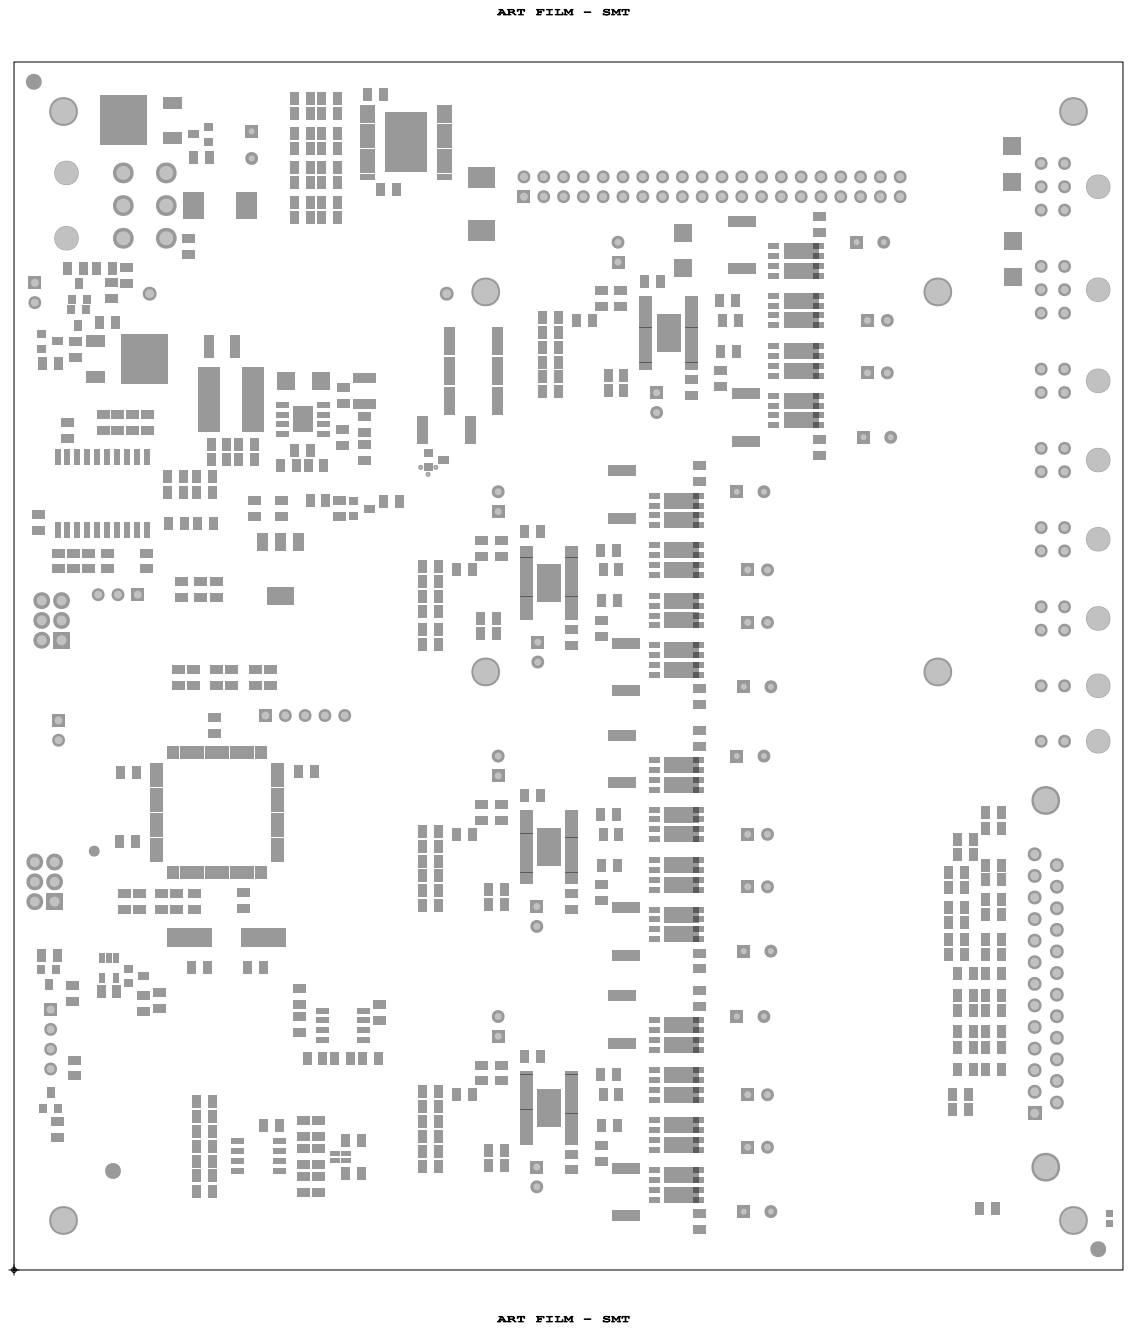
[picture p32: page 5]

ART FILM - SMT

## ART FILM - SST

# R24 C22 R25

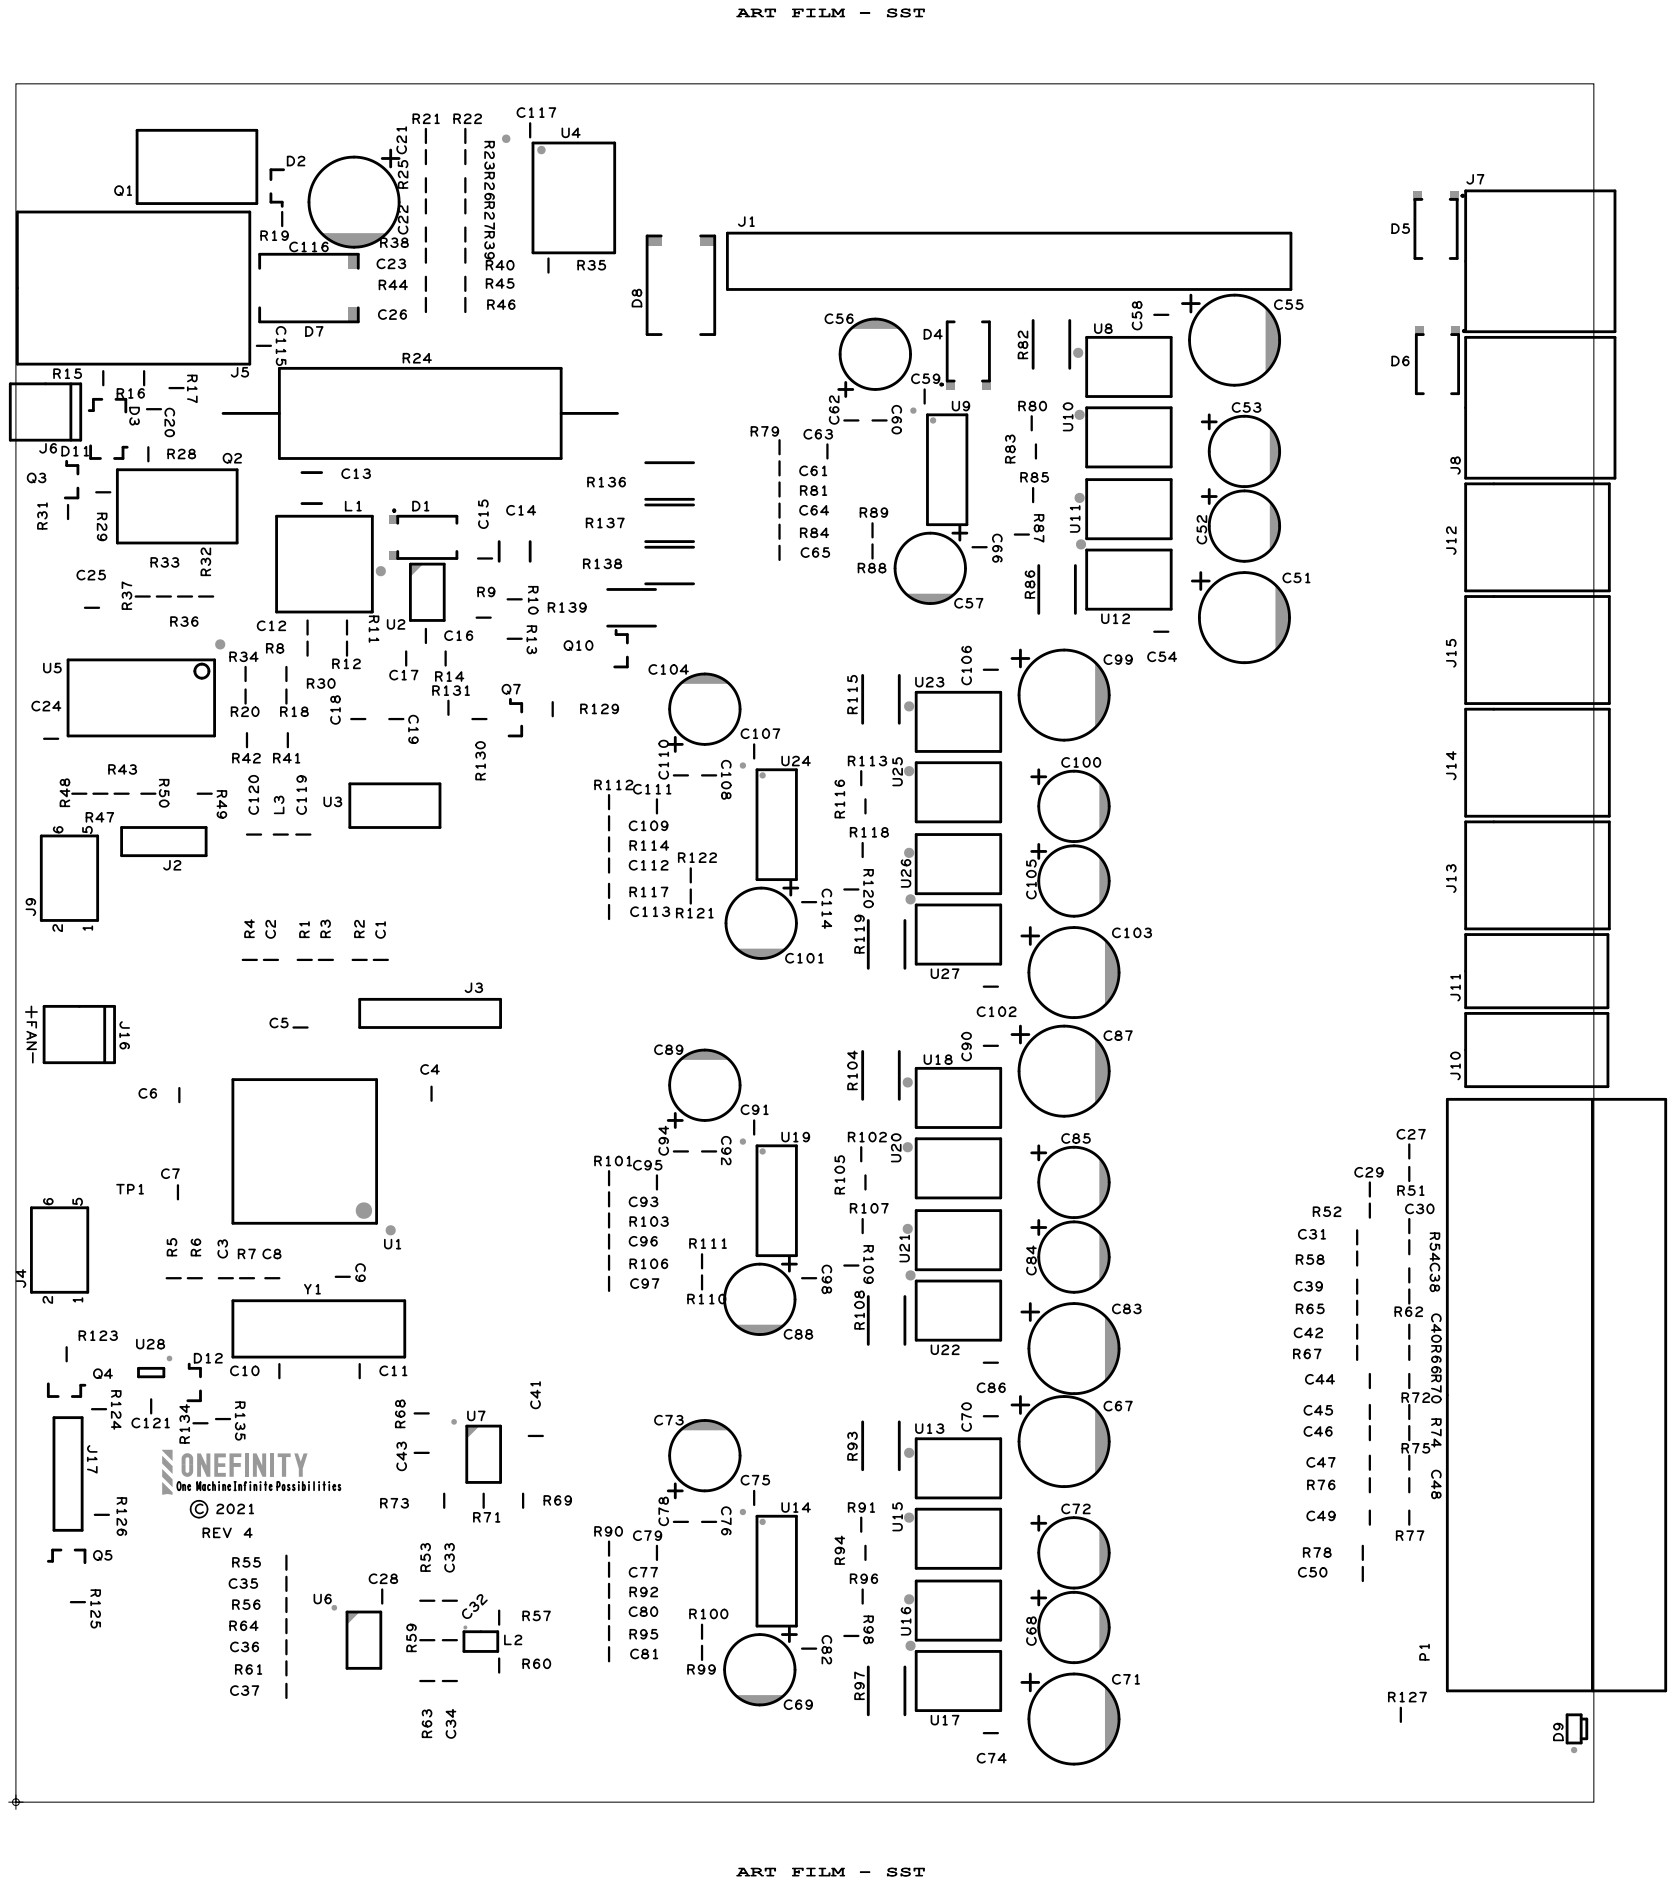
[picture p33: page 6]

## ART FILM - SMB

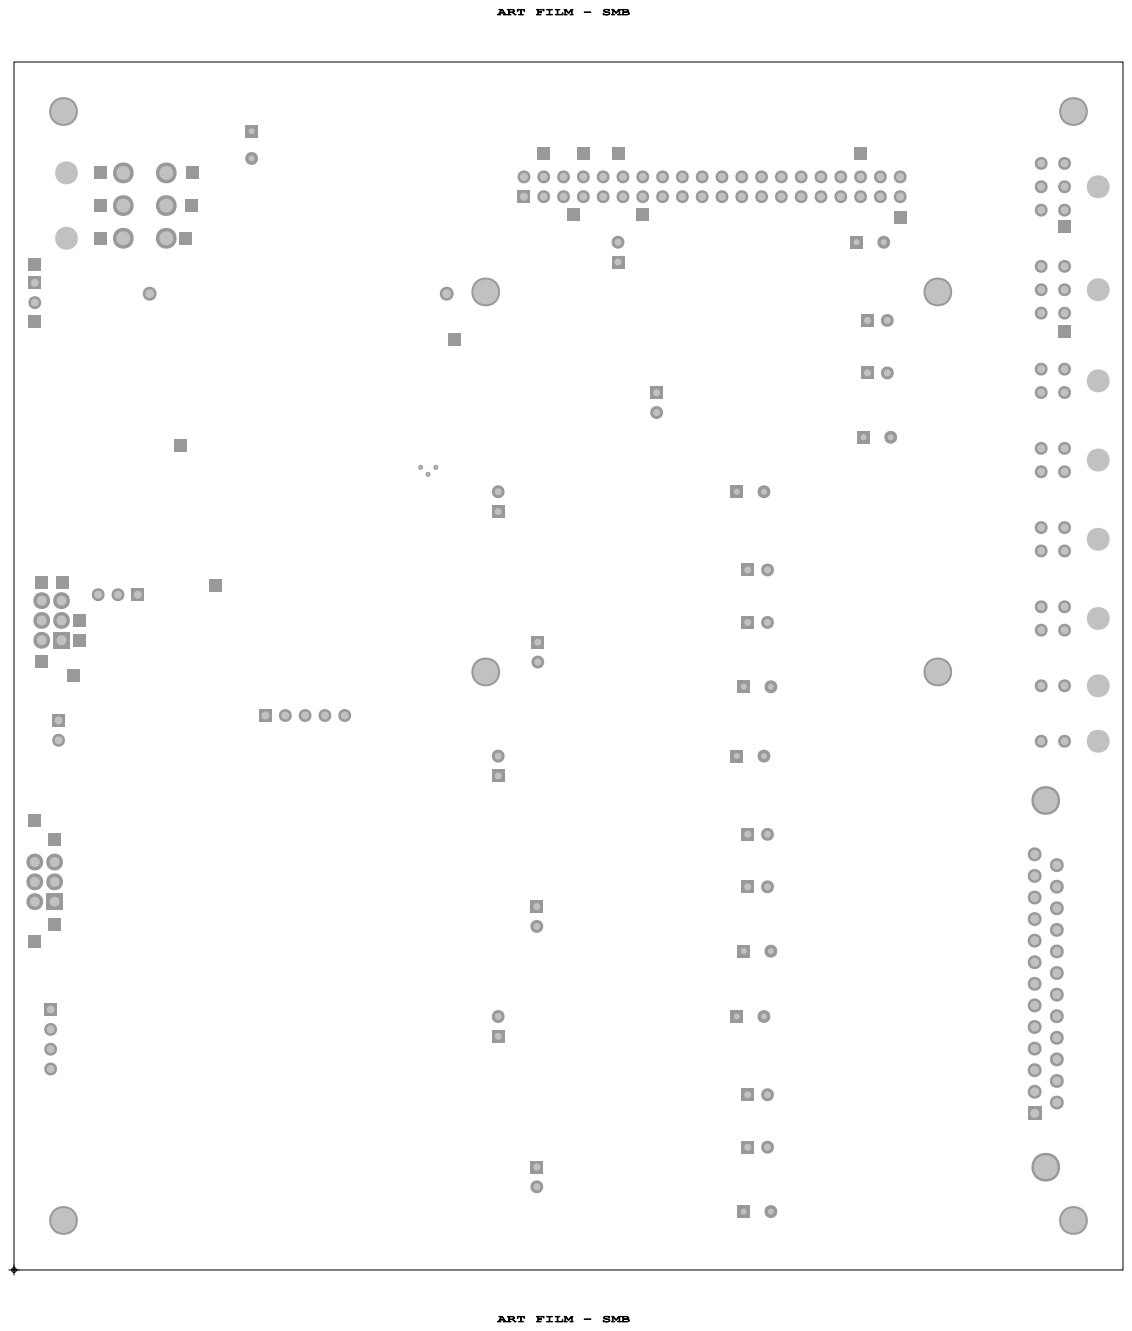
[picture p34: page 7]

ART FILM - SMB
