OneFinityCNC/onefinity-pcb/(list of files, drawings)

Other design files:
Schematics/CONTROLLER_REV4.DSN
Schematics/CONTROLLER_REV5.DSN
