OneFinityCNC/onefinity-pcb/(commit log)

2020-08-28 Inital Release
    Rev 2 of controller board. Based on Buildbotics controller V12. (www.buildbotics.com)
    [OneFinity.DSN, OneFinityCNC-Rev2.xlsx]
2021-01-22 Fixed title block to reflect correct license
    [OneFinity.DSN]
2022-01-20 Create BOM
